antmerlino/Micromouse/Pictures/overalldesign_noIR.jpg

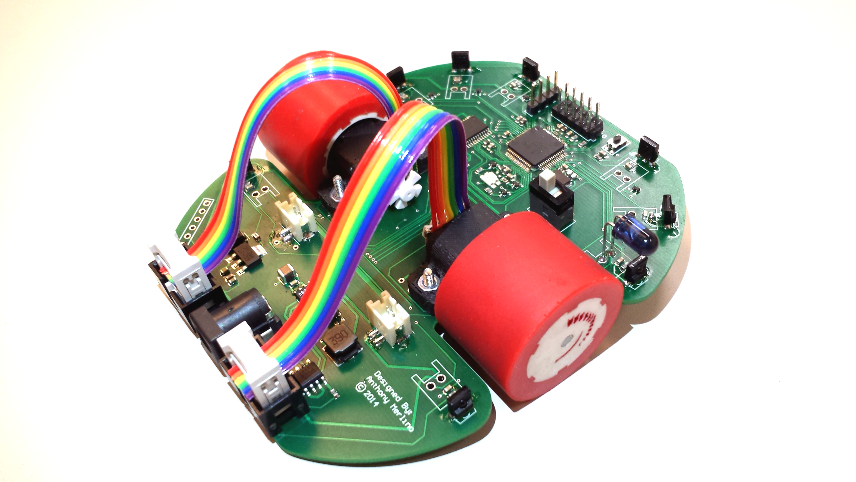
Pictures/overalldesign_noIR.jpg
