antmerlino/Micromouse/README.md

Micromouse
==========

Hardware and Software Design for IEEE Micromouse Competition
