antmerlino/Micromouse/Hardware/pin_information.xlsx

Sheet: Signals By Pin Number
Pin Number | Pin Name | Pin Type | Buffer Type | Description
1 | PB6 | I/O | TTL | GPIO port B bit 6.
 | M0PWM0 | O | TTL | Motion Control Module 0 PWM 0. This signal is controlled by Module 0 PWM Generator 0.
 | SSI2Rx | I | TTL | SSI module 2 receive.
 | T0CCP0 | I/O | TTL | 16/32-Bit Timer 0 Capture/Compare/PWM 0.
2 | VDDA | - | Power | The positive supply for the analog circuits (ADC, Analog Comparators, etc.). These are separated from VDD to minimize the electrical noise contained on VDD from affecting the analog functions. VDDA pins must be supplied with a voltage that meets the specification in Table 24-5 on page 1355, regardless of system implementation.
3 | GNDA | - | Power | The ground reference for the analog circuits (ADC, Analog Comparators, etc.). These are separated from GND to minimize the electrical noise contained on VDD from affecting the analog functions.
4 | PB7 | I/O | TTL | GPIO port B bit 7.
 | M0PWM1 | O | TTL | Motion Control Module 0 PWM 1. This signal is controlled by Module 0 PWM Generator 0.
 | SSI2Tx | O | TTL | SSI module 2 transmit.
 | T0CCP1 | I/O | TTL | 16/32-Bit Timer 0 Capture/Compare/PWM 1.
5 | PF4 | I/O | TTL | GPIO port F bit 4.
 | IDX0 | I | TTL | QEI module 0 index.
 | M1FAULT0 | I | TTL | Motion Control Module 1 PWM Fault 0.
 | T2CCP0 | I/O | TTL | 16/32-Bit Timer 2 Capture/Compare/PWM 0.
 | USB0EPEN | O | TTL | Optionally used in Host mode to control an external power source to supply power to the USB bus.
6 | PE3 | I/O | TTL | GPIO port E bit 3.
 | AIN0 | I | Analog | Analog-to-digital converter input 0.
7 | PE2 | I/O | TTL | GPIO port E bit 2.
 | AIN1 | I | Analog | Analog-to-digital converter input 1.
8 | PE1 | I/O | TTL | GPIO port E bit 1.
 | AIN2 | I | Analog | Analog-to-digital converter input 2.
 | U7Tx | O | TTL | UART module 7 transmit.
9 | PE0 | I/O | TTL | GPIO port E bit 0.
 | AIN3 | I | Analog | Analog-to-digital converter input 3.
 | U7Rx | I | TTL | UART module 7 receive.
10 | PD7 | I/O | TTL | GPIO port D bit 7.
 | NMI | I | TTL | Non-maskable interrupt.
 | PhB0 | I | TTL | QEI module 0 phase B.
 | U2Tx | O | TTL | UART module 2 transmit.
 | WT5CCP1 | I/O | TTL | 32/64-Bit Wide Timer 5 Capture/Compare/PWM 1.
11 | VDD | - | Power | Positive supply for I/O and some logic.
12 | GND | - | Power | Ground reference for logic and I/O pins.
13 | PC7 | I/O | TTL | GPIO port C bit 7.
 | C0- | I | Analog | Analog comparator 0 negative input.
 | U3Tx | O | TTL | UART module 3 transmit.
 | USB0PFLT | I | TTL | Optionally used in Host mode by an external power source to indicate an error state by that power source.
 | WT1CCP1 | I/O | TTL | 32/64-Bit Wide Timer 1 Capture/Compare/PWM 1.
14 | PC6 | I/O | TTL | GPIO port C bit 6.
 | C0+ | I | Analog | Analog comparator 0 positive input.
 | PhB1 | I | TTL | QEI module 1 phase B.
 | U3Rx | I | TTL | UART module 3 receive.
 | USB0EPEN | O | TTL | Optionally used in Host mode to control an external power source to supply power to the USB bus.
 | WT1CCP0 | I/O | TTL | 32/64-Bit Wide Timer 1 Capture/Compare/PWM 0.
15 | PC5 | I/O | TTL | GPIO port C bit 5.
 | C1+ | I | Analog | Analog comparator 1 positive input.
 | M0PWM7 | O | TTL | Motion Control Module 0 PWM 7. This signal is controlled by Module 0 PWM Generator 3.
 | PhA1 | I | TTL | QEI module 1 phase A.
 | U1CTS | I | TTL | UART module 1 Clear To Send modem flow control input signal.
 | U1Tx | O | TTL | UART module 1 transmit.
 | U4Tx | O | TTL | UART module 4 transmit.
 | WT0CCP1 | I/O | TTL | 32/64-Bit Wide Timer 0 Capture/Compare/PWM 1.
16 | PC4 | I/O | TTL | GPIO port C bit 4.
 | C1- | I | Analog | Analog comparator 1 negative input.
 | IDX1 | I | TTL | QEI module 1 index.
 | M0PWM6 | O | TTL | Motion Control Module 0 PWM 6. This signal is controlled by Module 0 PWM Generator 3.
 | U1RTS | O | TTL | UART module 1 Request to Send modem flow control output line.
 | U1Rx | I | TTL | UART module 1 receive.
 | U4Rx | I | TTL | UART module 4 receive.
 | WT0CCP0 | I/O | TTL | 32/64-Bit Wide Timer 0 Capture/Compare/PWM 0.
17 | PA0 | I/O | TTL | GPIO port A bit 0.
 | CAN1Rx | I | TTL | CAN module 1 receive.
 | U0Rx | I | TTL | UART module 0 receive.
18 | PA1 | I/O | TTL | GPIO port A bit 1.
 | CAN1Tx | O | TTL | CAN module 1 transmit.
 | U0Tx | O | TTL | UART module 0 transmit.
19 | PA2 | I/O | TTL | GPIO port A bit 2.
 | SSI0Clk | I/O | TTL | SSI module 0 clock
20 | PA3 | I/O | TTL | GPIO port A bit 3.
 | SSI0Fss | I/O | TTL | SSI module 0 frame signal
21 | PA4 | I/O | TTL | GPIO port A bit 4.
 | PA5 | O | TTL | SSI module 0 receive
22 | SSI0Tx | O | TTL | SSI module 0 transmit
 | PA6 | I/O | TTL | GPIO port A bit 6.
23 | I2C1SCL | I/O | OD | I2C module 1 clock. Note that this signal has an active pull-up. The corresponding port pin should not be configured as open drain.
 | M1PWM2 | O | TTL | Motion Control Module 1 PWM 2. This signal is controlled by Module 1 PWM Generator 1.
24 | PA7 | I/O | TTL | GPIO port A bit 7.
 | I2C1SDA | I/O | OD | I2C module 1 data.
 | M1PWM3 | O | TTL | Motion Control Module 1 PWM 3. This signal is controlled by Module 1 PWM Generator 1.
25 | VDDC | - | Power | Positive supply for most of the logic function, including the processor core and most peripherals. The voltage on this pin is 1.2 V and is supplied by the on-chip LDO. The VDDC pins should only be connected to each other and an external capacitor specified in Table 24-12 on page 1367 .
26 | VDD | - | Power | Positive supply for I/O and some logic.
27 | GND | - | Power | Ground reference for logic and I/O pins.
28 | PF0 | I/O | TTL | GPIO port F bit 0.
 | C0o | O | TTL | Analog comparator 0 output.
 | CAN0Rx | I | TTL | CAN module 0 receive.
 | M1PWM4 | O | TTL | Motion Control Module 1 PWM 4. This signal is controlled by Module 1 PWM Generator 2.
 | NMI | I | TTL | Non-maskable interrupt.
 | PhA0 | I | TTL | QEI module 0 phase A.
 | SSI1Rx | I | TTL | SSI module 1 receive.
 | T0CCP0 | I/O | TTL | 16/32-Bit Timer 0 Capture/Compare/PWM 0.
 | U1RTS | O | TTL | UART module 1 Request to Send modem flow control output line.
29 | PF1 | I/O | TTL | GPIO port F bit 1.
 | C1o | O | TTL | Analog comparator 1 output.
 | M1PWM5 | O | TTL | Motion Control Module 1 PWM 5. This signal is controlled by Module 1 PWM Generator 2.
 | PhB0 | I | TTL | QEI module 0 phase B.
 | SSI1Tx | O | TTL | SSI module 1 transmit.
 | T0CCP1 | I/O | TTL | 16/32-Bit Timer 0 Capture/Compare/PWM 1.
 | TRD1 | O | TTL | Trace data 1.
 | U1CTS | I | TTL | UART module 1 Clear To Send modem flow control input signal.
30 | PF2 | I/O | TTL | GPIO port F bit 2.
 | M0FAULT0 | I | TTL | Motion Control Module 0 PWM Fault 0.
 | M1PWM6 | O | TTL | Motion Control Module 1 PWM 6. This signal is controlled by Module 1 PWM Generator 3.
 | SSI1Clk | I/O | TTL | SSI module 1 clock.
 | T1CCP0 | I/O | TTL | 16/32-Bit Timer 1 Capture/Compare/PWM 0.
 | TRD0 | O | TTL | Trace data 0.
31 | PF3 | I/O | TTL | GPIO port F bit 3.
 | CAN0Tx | O | TTL | CAN module 0 transmit.
 | M1PWM7 | O | TTL | Motion Control Module 1 PWM 7. This signal is controlled by Module 1 PWM Generator 3.
 | SSI1Fss | I/O | TTL | SSI module 1 frame signal.
 | T1CCP1 | I/O | TTL | 16/32-Bit Timer 1 Capture/Compare/PWM 1.
 | TRCLK | O | TTL | Trace clock.
32 | WAKE | I | TTL | An external input that brings the processor out of Hibernate mode when asserted.
33 | HIB | O | TTL | An output that indicates the processor is in Hibernate mode.
34 | XOSC0 | I | Analog | Hibernation module oscillator crystal input or an external clock reference input. Note that this is either a 32.768-kHz crystal or a 32.768-kHz oscillator for the Hibernation module RTC.
35 | GNDX | - | Power | GND for the Hibernation oscillator. When using a crystal clock source, this pin should be connected to digital ground along with the crystal load capacitors. When using an external oscillator, this pin should be connected to digital ground
36 | XOSC1 | O | Analog | Hibernation module oscillator crystal output. Leave unconnected when using a single-ended clock source.
37 | VBAT | - | Power | Power source for the Hibernation module. It is normally connected to the positive terminal of a battery and serves as the battery backup/Hibernation module power-source supply. to the positive terminal of a battery and serves as the battery backup/Hibernation module power-source supply
38 | RST | I | TTL | System reset input.
39 | GND | - | Power | Ground reference for logic and I/O pins.
40 | OSC0 | I | Analog | Main oscillator crystal input or an external clock reference input.
41 | OSC1 | O | Analog | Main oscillator crystal output. Leave unconnected when using a single-ended clock source.
42 | VDD | - | Power | Positive supply for I/O and some logic.
43 | PD4 | I/O | TTL | GPIO port D bit 4. This pin is not 5-V tolerant.
 | U6Rx | I | TTL | UART module 6 receive.
 | USB0DM | I/O | Analog | Bidirectional differential data pin (D- per USB specification) for USB0.
44 | WT4CCP0 | I/O | TTL | 32/64-Bit Wide Timer 4 Capture/Compare/PWM 0.
 | PD5 | I/O | TTL | GPIO port D bit 5. This pin is not 5-V tolerant.
 | U6Tx | O | TTL | UART module 6 transmit.
 | USB0DP | I/O | Analog | Bidirectional differential data pin (D+ per USB specification) for USB0.
 | WT4CCP1 | I/O | TTL | 32/64-Bit Wide Timer 4 Capture/Compare/PWM 1.
45 | PB0 | I/O | TTL | GPIO port B bit 0. This pin is not 5-V tolerant
 | T2CCP0 | I/O | TTL | 16/32-Bit Timer 2 Capture/Compare/PWM 0
 | U1RX | I | TTL | UART module 1 receive
 | USB0ID | I | Analog | This signal senses the state of the USB ID signal. The USB PHY enables an integrated pull-up, and an external element (USB connector) indicates the initial state of the USB controller (pulled down is the A side of the cable and pulled up is the B side)
46 | PB1 | I/O | TTL | GPIO port B bit 1. This pin is not 5-V tolerant
 | T2CCP1 | I/O | TTL | 16/32-Bit Timer 2 Capture/Compare/PWM 1
 | U1Tx | O | TTL | UART module 1 transmit.
 | USB0VBUS | I/O | Analog | This signal is used during the session request protocol. This signal allows the USB PHY to both sense the voltage level of VBUS, and pull up VBUS momentarily during VBUS pulsing
47 | PB2 | I/O | TTL | GPIO port A bit 2.
 | I2C0SCL | I/O | OD | I2C module 0 clock. Note that this signal has an active pull-up. The corresponding port pin should not be configured as open drain.
 | T3CCP1 | I/O | TTL | 16/32-Bit Timer 3 Capture/Compare/PWM 1
48 | PB3 | I/O | TTL | GPIO port B bit 3.
 | I2C0SDA | I/O | OD | I2C module 0 data.
 | T3CCP1 | I/O | TTL | 16/32-Bit Timer 3 Capture/Compare/PWM 1.
49 | PC3 | I/O | TTL | GPIO port C bit 3.
 | SWO | O | TTL | JTAG TDO and SWO.
 | T5CCP1 | I/O | TTL | 16/32-Bit Timer 5 Capture/Compare/PWM 1.
 | TDO | O | TTL | JTAG TDO and SWO.
50 | PC2 | I/O | TTL | GPIO port C bit 2.
 | T5CCP0 | I/O | TTL | 16/32-Bit Timer 5 Capture/Compare/PWM 0.
 | TDI | I | TTL | JTAG TDI.
51 | PC1 | I/O | TTL | GPIO port C bit 1.
 | SWDIO | I/O | TTL | JTAG TMS and SWDIO.
 | T4CCP1 | I/O | TTL | 16/32-Bit Timer 4 Capture/Compare/PWM 1.
 | TMS | I | TTL | JTAG TMS and SWDIO.
52 | PC0 | I/O | TTL | GPIO port C bit 0.
 | SWCLK | I | TTL | JTAG/SWD CLK.
 | T4CCP0 | I/O | TTL | 16/32-Bit Timer 4 Capture/Compare/PWM 0.
 | TCK | I | TTL | JTAG/SWD CLK.
53 | PD6 | I/O | TTL | GPIO port D bit 6.
 | M0FAULT0 | I | TTL | Motion Control Module 0 PWM Fault 0.
 | PhA0 | I | TTL | QEI module 0 phase A.
 | U2Rx | I | TTL | UART module 2 receive.
 | WT5CCP0 | I/O | TTL | 32/64-Bit Wide Timer 5 Capture/Compare/PWM 0.
54 | VDD | - | Power | Positive supply for I/O and some logic.
55 | GND | - | Power | Ground reference for logic and I/O pins.
56 | VDDC | - | Power | Positive supply for most of the logic function, including the processor core and most peripherals. The voltage on this pin is 1.2 V and is supplied by the on-chip LDO. The VDDC pins should only be connected to each other and an external capacitor as specified in Table 24-12 on page 1367 .
57 | PB5 | I/O | TTL | GPIO port B bit 5.
 | AIN11 | I | Analog | Analog-to-digital converter input 11.
 | CAN0Tx | O | TTL | CAN module 0 transmit.
 | M0PWM3 | O | TTL | Motion Control Module 0 PWM 3. This signal is controlled by Module 0 PWM Generator 1.
 | SSI2Fss | I/O | TTL | SSI module 2 frame signal.
 | T1CCP1 | I/O | TTL | 16/32-Bit Timer 1 Capture/Compare/PWM 1.
58 | PB4 | I/O | TTL | GPIO port B bit 4.
 | AIN10 | I | Analog | Analog-to-digital converter input 10.
 | CAN0Rx | I | TTL | CAN module 0 receive.
 | M0PWM2 | O | TTL | Motion Control Module 0 PWM 2. This signal is controlled by Module 0 PWM Generator 1.
 | SSI2Clk | I/O | TTL | SSI module 2 clock.
 | T1CCP0 | I/O | TTL | 16/32-Bit Timer 1 Capture/Compare/PWM 0.
59 | PE4 | I/O | TTL | GPIO port E bit 4.
 | AIN9 | I | Analog | Analog-to-digital converter input 9.
 | CAN0Rx | I | TTL | CAN module 0 receive.
 | I2C2SCL | I/O | OD | I2C module 2 clock. Note that this signal has an active pull-up. The corresponding port pin should not be configured as open drain.
 | M0PWM4 | O | TTL | Motion Control Module 0 PWM 4. This signal is controlled by Module 0 PWM Generator 2.
 | M1PWM2 | O | TTL | Motion Control Module 1 PWM 2. This signal is controlled by Module 1 PWM Generator 1.
 | U5Rx | I | TTL | UART module 5 receive.
60 | PE5 | I/O | TTL | GPIO port E bit 5.
 | AIN8 | I | Analog | Analog-to-digital converter input 8.
 | CAN0Tx | O | TTL | CAN module 0 transmit.
 | I2C2SDA | I/O | OD | I2C module 2 data.
 | M0PWM5 | O | TTL | Motion Control Module 0 PWM 5. This signal is controlled by Module 0 PWM Generator 2.
 | M1PWM3 | O | TTL | Motion Control Module 1 PWM 3. This signal is controlled by Module 1 PWM Generator 1.
 | U5Tx | O | TTL | UART module 5 transmit.
61 | PD0 | I/O | TTL | GPIO port D bit 0.
 | AIN7 | I | Analog | Analog-to-digital converter input 7.
 | I2C3SCL | I/O | OD | I2C module 3 clock. Note that this signal has an active pull-up. The corresponding port pin should not be configured as open drain.
 | M0PWM6 | O | TTL | Motion Control Module 0 PWM 6. This signal is controlled by Module 0 PWM Generator 3.
 | M1PWM0 | O | TTL | Motion Control Module 1 PWM 0. This signal is controlled by Module 1 PWM Generator 0.
 | SSI1Clk | I/O | TTL | SSI module 1 clock.
 | SSI3Clk | I/O | TTL | SSI module 3 clock.
 | WT2CCP0 | I/O | TTL | 32/64-Bit Wide Timer 2 Capture/Compare/PWM 0.
62 | PD1 | I/O | TTL | GPIO port D bit 1.
 | AIN6 | I | Analog | Analog-to-digital converter input 6.
 | I2C3SDA | I/O | OD | I2C module 3 data.
 | M0PWM7 | O | TTL | Motion Control Module 0 PWM 7. This signal is controlled by
 | M1PWM1 | O | TTL | Motion Control Module 1 PWM 1. This signal is controlled by Module 1 PWM Generator 0.
 | SSI1Fss | I/O | TTL | SSI module 1 frame signal.
 | SSI3Fss | I/O | TTL | SSI module 3 frame signal.
 | WT2CCP1 | I/O | TTL | 32/64-Bit Wide Timer 2 Capture/Compare/PWM 1.
63 | PD2 | I/O | TTL | GPIO port D bit 2.
 | AIN5 | I | Analog | Analog-to-digital converter input 5.
 | M0FAULT0 | I | TTL | Motion Control Module 0 PWM Fault 0.
 | SSI1Rx | I | TTL | SSI module 1 receive.
 | SSI3Rx | I | TTL | SSI module 3 receive.
 | USB0EPEN | O | TTL | Optionally used in Host mode to control an external power source to supply power to the USB bus.
 | WT3CCP0 | I/O | TTL | 32/64-Bit Wide Timer 3 Capture/Compare/PWM 0.
64 | PD3 | I/O | TTL | GPIO port D bit 3.
 | AIN4 | I | Analog | Analog-to-digital converter input 4.
 | IDX0 | I | TTL | QEI module 0 index.
 | SSI1Tx | O | TTL | SSI module 1 transmit.
 | SSI3Tx | O | TTL | SSI module 3 transmit.
 | USB0PFLT | I | TTL | Optionally used in Host mode by an external power source to indicate an error state by that power source.
 | WT3CCP1 | I/O | TTL | 32/64-Bit Wide Timer 3 Capture/Compare/PWM 1.

Sheet: Signals By Pin Name
Pin Name | Pin Number | Pin Mux / Pin Assignment | Pin Type | Buffer Typea | Description
AIN0 | 6 | PE3 | I | Analog | Analog-to-digital converter input 0.
AIN1 | 7 | PE2 | I | Analog | Analog-to-digital converter input 1.
AIN2 | 8 | PE1 | I | Analog | Analog-to-digital converter input 2.
AIN3 | 9 | PE0 | I | Analog | Analog-to-digital converter input 3.
AIN4 | 64 | PD3 | I | Analog | Analog-to-digital converter input 4.
AIN5 | 63 | PD2 | I | Analog | Analog-to-digital converter input 5.
AIN6 | 62 | PD1 | I | Analog | Analog-to-digital converter input 6.
AIN7 | 61 | PD0 | I | Analog | Analog-to-digital converter input 7.
AIN8 | 60 | PE5 | I | Analog | Analog-to-digital converter input 8.
AIN9 | 59 | PE4 | I | Analog | Analog-to-digital converter input 9.
AIN10 | 58 | PB4 | I | Analog | Analog-to-digital converter input 10.
AIN11 | 57 | PB5 | I | Analog | Analog-to-digital converter input 11.
C0+ | 14 | PC6 | I | Analog | Analog comparator 0 positive input.
C0- | 13 | PC7 | I | Analog | Analog comparator 0 negative input.
C0o | 28 | PF0 (9) | O | TTL | Analog comparator 0 output.
C1+ | 15 | PC5 | I | Analog | Analog comparator 1 positive input.
C1- | 16 | PC4 | I | Analog | Analog comparator 1 negative input.
C1o | 29 | PF1 (9) | O | TTL | Analog comparator 1 output.
CAN0Rx | 28 | PF0 (3) | I | TTL | CAN module 0 receive.
 | 58 | PB4 (8)
 | 59 | PE4 (8)
CAN0Tx | 31 | PF3 (3) | O | TTL | CAN module 0 transmit.
 | 57 | PB5 (8)
 | 60 | PE5 (8)
CAN1Rx | 17 | PA0 (8) | I | TTL | CAN module 1 receive.
CAN1Tx | 18 | PA1 (8) | O | TTL | CAN module 1 transmit.
GND | 12 | fixed | - | Power | Ground reference for logic and I/O pins.
 | 27
 | 39
 | 55
GNDA | 3 | fixed | - | Power | The ground reference for the analog circuits (ADC, Analog Comparators, etc.). These are separated from GND to minimize the electrical noise contained on VDD from affecting the analog functions.
GNDX | 35 | fixed | - | Power | GND for the Hibernation oscillator. When using a crystal clock source, this pin should be connected capacitors. When using an external oscillator, this pin should be connected to digital ground.
HIB | 33 | fixed | O | TTL | An output that indicates the processor is in active pull-up. The corresponding port pin should Hibernate mode.
I2C0SCL | 47 | PB2 (3) | I/O | OD | I2C module 0 clock. Note that this signal has an not be configured as open drain.
I2C0SDA | 48 | PB3 (3) | I/O | OD | I2C module 0 data.
I2C1SCL | 23 | PA6 (3) | I/O | OD | I2C module 1 clock. Note that this signal has an active pull-up. The corresponding port pin should not be configured as open drain.
I2C1SDA | 24 | PA7 (3) | I/O | OD | I2C module 1 data.
I2C2SCL | 59 | PE4 (3) | I/O | OD | I2C module 2 clock. Note that this signal has an active pull-up. The corresponding port pin should not be configured as open drain.
I2C2SDA | 60 | PE5 (3) | I/O | OD | I2C module 2 data.
I2C3SCL | 61 | PD0 (3) | I/O | OD | I2C module 3 clock. Note that this signal has an active pull-up. The corresponding port pin should not be configured as open drain.
I2C3SDA | 62 | PD1 (3) | I/O | OD | I2C module 3 data.
IDX0 | 5 | PF4 (6) | I | TTL | QEI module 0 index.
 | 64 | PD3 (6)
IDX1 | 16 | PC4 (6) | I | TTL | QEI module 1 index.
M0FAULT0 | 30 | PF2 (4) | I | TTL | Motion Control Module 0 PWM Fault 0.
 | 53 | PD6 (4)
 | 63 | PD2 (4)
M0PWM0 | 1 | PB6 (4) | O | TTL | Motion Control Module 0 PWM 0. This signal is controlled by Module 0 PWM Generator 0.
M0PWM1 | 4 | PB7 (4) | O | TTL | Motion Control Module 0 PWM 1. This signal is controlled by Module 0 PWM Generator 0.
M0PWM2 | 58 | PB4 (4) | O | TTL | Motion Control Module 0 PWM 2. This signal is controlled by Module 0 PWM Generator 1.
M0PWM3 | 57 | PB5 (4) | O | TTL | Motion Control Module 0 PWM 3. This signal is controlled by Module 0 PWM Generator 1.
M0PWM4 | 59 | PE4 (4) | O | TTL | Motion Control Module 0 PWM 4. This signal is controlled by Module 0 PWM Generator 2.
M0PWM5 | 60 | PE5 (4) | O | TTL | Motion Control Module 0 PWM 5. This signal is controlled by Module 0 PWM Generator 2.
M0PWM6 | 16 | PC4 (4) | O | TTL | Motion Control Module 0 PWM 6. This signal is controlled by Module 0 PWM Generator 3.
 | 61 | PD0 (4)
M0PWM7 | 15 | PC5 (4) | O | TTL | Motion Control Module 0 PWM 7. This signal is controlled by Module 0 PWM Generator 3.
 | 62 | PD1 (4)
M1FAULT0 | 5 | PF4 (5) | I | TTL | Motion Control Module 1 PWM Fault 0.
M1PWM0 | 61 | PD0 (5) | O | TTL | Motion Control Module 1 PWM 0. This signal is controlled by Module 1 PWM Generator 0.
M1PWM1 | 62 | PD1 (5) | O | TTL | Motion Control Module 1 PWM 1. This signal is controlled by Module 1 PWM Generator 0.
M1PWM2 | 23 | PA6 (5) | O | TTL | Motion Control Module 1 PWM 2. This signal is controlled by Module 1 PWM Generator 1.
 | 59 | PE4 (5)
M1PWM3 | 24 | PA7 (5) | O | TTL | Motion Control Module 1 PWM 3. This signal is controlled by Module 1 PWM Generator 1.
 | 60 | PE5 (5)
M1PWM4 | 28 | PF0 (5) | O | TTL | Motion Control Module 1 PWM 4. This signal is controlled by Module 1 PWM Generator 2.
M1PWM5 | 29 | PF1 (5) | O | TTL | Motion Control Module 1 PWM 5. This signal is controlled by Module 1 PWM Generator 2.
M1PWM6 | 30 | PF2 (5) | O | TTL | Motion Control Module 1 PWM 6. This signal is controlled by Module 1 PWM Generator 3.
M1PWM7 | 31 | PF3 (5) | O | TTL | Motion Control Module 1 PWM 7. This signal is controlled by Module 1 PWM Generator 3.
NMI | 10 | PD7 (8) | I | TTL | Non-maskable interrupt.
 | 28 | PF0 (8)
OSC0 | 40 | fixed | I | Analog | Main oscillator crystal input or an external clock reference input.
OSC1 | 41 | fixed | O | Analog | Main oscillator crystal output. Leave unconnected when using a single-ended clock source.
PA0 | 17 | - | I/O | TTL | GPIO port A bit 0.
PA1 | 18 | - | I/O | TTL | GPIO port A bit 1.
PA2 | 19 | - | I/O | TTL | GPIO port A bit 2.
PA3 | 20 | - | I/O | TTL | GPIO port A bit 3.
PA4 | 21 | - | I/O | TTL | GPIO port A bit 4.
PA5 | 22 | - | I/O | TTL | GPIO port A bit 5.
PA6 | 23 | - | I/O | TTL | GPIO port A bit 6.
PA7 | 24 | - | I/O | TTL | GPIO port A bit 7.
PB0 | 45 | - | I/O | TTL | GPIO port B bit 0. This pin is not 5-V tolerant.
PB1 | 46 | - | I/O | TTL | GPIO port B bit 1. This pin is not 5-V tolerant.
PB2 | 47 | - | I/O | TTL | GPIO port B bit 2.
PB3 | 48 | - | I/O | TTL | GPIO port B bit 3.
PB4 | 58 | - | I/O | TTL | GPIO port B bit 4.
PB5 | 57 | - | I/O | TTL | GPIO port B bit 5.
PB6 | 1 | - | I/O | TTL | GPIO port B bit 6.
PB7 | 4 | - | I/O | TTL | GPIO port B bit 7.
PC0 | 52 | - | I/O | TTL | GPIO port C bit 0.
PC1 | 51 | - | I/O | TTL | GPIO port C bit 1.
PC2 | 50 | - | I/O | TTL | GPIO port C bit 2.
PC3 | 49 | - | I/O | TTL | GPIO port C bit 3.
PC4 | 16 | - | I/O | TTL | GPIO port C bit 4.
PC5 | 15 | - | I/O | TTL | GPIO port C bit 5.
PC6 | 14 | - | I/O | TTL | GPIO port C bit 6.
PC7 | 13 | - | I/O | TTL | GPIO port C bit 7.
PD0 | 61 | - | I/O | TTL | GPIO port D bit 0.
PD1 | 62 | - | I/O | TTL | GPIO port D bit 1.
PD2 | 63 | - | I/O | TTL | GPIO port D bit 2.
PD3 | 64 | - | I/O | TTL | GPIO port D bit 3.
PD4 | 43 | - | I/O | TTL | GPIO port D bit 4. This pin is not 5-V tolerant.
PD5 | 44 | - | I/O | TTL | GPIO port D bit 5. This pin is not 5-V tolerant.
PD6 | 53 | - | I/O | TTL | GPIO port D bit 6.
PD7 | 10 | - | I/O | TTL | GPIO port D bit 7.
PE0 | 9 | - | I/O | TTL | GPIO port E bit 0.
PE1 | 8 | - | I/O | TTL | GPIO port E bit 1.
PE2 | 7 | - | I/O | TTL | GPIO port E bit 2.
PE3 | 6 | - | I/O | TTL | GPIO port E bit 3.
PE4 | 59 | - | I/O | TTL | GPIO port E bit 4.
PE5 | 60 | - | I/O | TTL | GPIO port E bit 5.
PF0 | 28 | - | I/O | TTL | GPIO port F bit 0.
PF1 | 29 | - | I/O | TTL | GPIO port F bit 1.
PF2 | 30 | - | I/O | TTL | GPIO port F bit 2.
PF3 | 31 | - | I/O | TTL | GPIO port F bit 3.
PF4 | 5 | - | I/O | TTL | GPIO port F bit 4.
PhA0 | 28 | PF0 (6) | I | TTL | QEI module 0 phase A.
 | 53 | PD6 (6)
PhA1 | 15 | PC5 (6) | I | TTL | QEI module 1 phase A.
PhB0 | 10 | PD7 (6) | I | TTL | QEI module 0 phase B.
 | 29 | PF1 (6)
PhB1 | 14 | PC6 (6) | I | TTL | QEI module 1 phase B.
RST | 38 | fixed | I | TTL | System reset input.
SSI0Clk | 19 | PA2 (2) | I/O | TTL | SSI module 0 clock
SSI0Fss | 20 | PA3 (2) | I/O | TTL | SSI module 0 frame signal
SSI0Rx | 21 | PA4 (2) | I | TTL | SSI module 0 receive
SSI0Tx | 22 | PA5 (2) | O | TTL | SSI module 0 transmit
SSI1Clk | 30 | PF2 (2) | I/O | TTL | SSI module 1 clock.
 | 61 | PD0 (2)
SSI1Fss | 31 | PF3 (2) | I/O | TTL | SSI module 1 frame signal.
 | 62 | PD1 (2)
SSI1Rx | 28 | PF0 (2) | I | TTL | SSI module 1 receive.
 | 63 | PD2 (2)
SSI1Tx | 29 | PF1 (2) | O | TTL | SSI module 1 transmit.
 | 64 | PD3 (2)
SSI2Clk | 58 | PB4 (2) | I/O | TTL | SSI module 2 clock.
SSI2Fss | 57 | PB5 (2) | I/O | TTL | SSI module 2 frame signal.
SSI2Rx | 1 | PB6 (2) | I | TTL | SSI module 2 receive.
SSI2Tx | 4 | PB7 (2) | O | TTL | SSI module 2 transmit.
SSI3Clk | 61 | PD0 (1) | I/O | TTL | SSI module 3 clock.
SSI3Fss | 62 | PD1 (1) | I/O | TTL | SSI module 3 frame signal.
SSI3Rx | 63 | PD2 (1) | I | TTL | SSI module 3 receive.
SSI3Tx | 64 | PD3 (1) | O | TTL | SSI module 3 transmit.
SWCLK | 52 | PC0 (1) | I | TTL | JTAG/SWD CLK.
SWDIO | 51 | PC1 (1) | I/O | TTL | JTAG TMS and SWDIO.
SWO | 49 | PC3 (1) | O | TTL | JTAG TDO and SWO.
T0CCP0 | 1 | PB6 (7) | I/O | TTL | 16/32-Bit Timer 0 Capture/Compare/PWM 0.
 | 28 | PF0 (7)
T0CCP1 | 4 | PB7 (7) | I/O | TTL | 16/32-Bit Timer 0 Capture/Compare/PWM 1.
 | 29 | PF1 (7)
T1CCP0 | 30 | PF2 (7) | I/O | TTL | 16/32-Bit Timer 1 Capture/Compare/PWM 0.
 | 58 | PB4 (7)
T1CCP1 | 31 | PF3 (7) | I/O | TTL | 16/32-Bit Timer 1 Capture/Compare/PWM 1.
 | 57 | PB5 (7)
T2CCP0 | 5 | PF4 (7) | I/O | TTL | 16/32-Bit Timer 2 Capture/Compare/PWM 0.
 | 45 | PB0 (7)
T2CCP1 | 46 | PB1 (7) | I/O | TTL | 16/32-Bit Timer 2 Capture/Compare/PWM 1.
T3CCP0 | 47 | PB2 (7) | I/O | TTL | 16/32-Bit Timer 3 Capture/Compare/PWM 0.
T3CCP1 | 48 | PB3 (7) | I/O | TTL | 16/32-Bit Timer 3 Capture/Compare/PWM 1.
T4CCP0 | 52 | PC0 (7) | I/O | TTL | 16/32-Bit Timer 4 Capture/Compare/PWM 0.
T4CCP1 | 51 | PC1 (7) | I/O | TTL | 16/32-Bit Timer 4 Capture/Compare/PWM 1.
T5CCP0 | 50 | PC2 (7) | I/O | TTL | 16/32-Bit Timer 5 Capture/Compare/PWM 0.
T5CCP1 | 49 | PC3 (7) | I/O | TTL | 16/32-Bit Timer 5 Capture/Compare/PWM 1.
TCK | 52 | PC0 (1) | I | TTL | JTAG/SWD CLK.
TDI | 50 | PC2 (1) | I | TTL | JTAG TDI.
TDO | 49 | PC3 (1) | O | TTL | JTAG TDO and SWO.
TMS | 51 | PC1 (1) | I | TTL | JTAG TMS and SWDIO.
TRCLK | 31 | PF3 (14) | O | TTL | Trace clock.
TRD0 | 30 | PF2 (14) | O | TTL | Trace data 0.
TRD1 | 29 | PF1 (14) | O | TTL | Trace data 1.
U0Rx | 17 | PA0 (1) | I | TTL | UART module 0 receive.
U0Tx | 18 | PA1 (1) | O | TTL | UART module 0 transmit.
U1CTS | 15 | PC5 (8) | I | TTL | UART module 1 Clear To Send modem flow control input signal.
 | 29 | PF1 (1)
U1RTS | 16 | PC4 (8) | O | TTL | UART module 1 Request to Send modem flow control output line.
 | 28 | PF0 (1)
U1Rx | 16 | PC4 (2) | I | TTL | UART module 1 receive.
 | 45 | PB0 (1)
U1Tx | 15 | PC5 (2) | O | TTL | UART module 1 transmit.
 | 46 | PB1 (1)
U2Rx | 53 | PD6 (1) | I | TTL | UART module 2 receive.
U2Tx | 10 | PD7 (1) | O | TTL | UART module 2 transmit.
U3Rx | 14 | PC6 (1) | I | TTL | UART module 3 receive.
U3Tx | 13 | PC7 (1) | O | TTL | UART module 3 transmit.
U4Rx | 16 | PC4 (1) | I | TTL | UART module 4 receive.
U4Tx | 15 | PC5 (1) | O | TTL | UART module 4 transmit.
U5Rx | 59 | PE4 (1) | I | TTL | UART module 5 receive.
U5Tx | 60 | PE5 (1) | O | TTL | UART module 5 transmit.
U6Rx | 43 | PD4 (1) | I | TTL | UART module 6 receive.
U6Tx | 44 | PD5 (1) | O | TTL | UART module 6 transmit.
U7Rx | 9 | PE0 (1) | I | TTL | UART module 7 receive.
U7Tx | 8 | PE1 (1) | O | TTL | UART module 7 transmit.
USB0DM | 43 | PD4 | I/O | Analog | Bidirectional differential data pin (D-per USB specification) for USB0.
USB0DP | 44 | PD5 | I/O | Analog | Bidirectional differential data pin (D+ per USB specification) for USB0.
USB0EPEN | 5 | PF4 (8) | O | TTL | Optionally used in Host mode to control an external power source to supply power to the USB bus.
 | 14 | PC6 (8)
 | 63 | PD2 (8)
USB0ID | 45 | PB0 | I | Analog | This signal senses the state of the USB ID signal. The USB PHY enables an integrated pull-up, and an external element (USB connector) indicates the initial state of the USB controller (pulled down is the A side of the cable and pulled up is the B side).
USB0PFLT | 13 | PC7 (8) | I | TTL | Optionally used in Host mode by an external power source to indicate an error state by that power source.
 | 64 | PD3 (8)
USB0VBUS | 46 | PB1 | I/O | Analog | This signal is used during the session request protocol. This signal allows the USB PHY to both sense the voltage level of VBUS, and pull up VBUS momentarily during VBUS pulsing.
VBAT | 37 | fixed | - | Power | Power source for the Hibernation module. It is normally connected to the positive terminal of a battery and serves as the battery backup/Hibernation module power-source supply.
VDD | 11 | fixed | - | Power | Positive supply for I/O and some logic.
 | 26
 | 42
 | 54
VDDA | 2 | fixed | - | Power | The positive supply for the analog circuits (ADC, Analog Comparators, etc.). These are separated from VDD to minimize the electrical noise contained on VDD from affecting the analog functions. VDDA pins must be supplied with a voltage that meets the specification in Table 24-5 on page 1355, regardless of system implementation.
VDDC | 25 | fixed | - | Power | Positive supply for most of the logic function, including the processor core and most peripherals. The voltage on this pin is 1.2 V and is supplied by the on-chip LDO. The VDDC pins should only be connected to each other and an external capacitor as specified in Table 24-12 on page 1367 .
 | 56
WAKE | 32 | fixed | I | TTL | An external input that brings the processor out of Hibernate mode when asserted.
WT0CCP0 | 16 | PC4 (7) | I/O | TTL | 32/64-Bit Wide Timer 0 Capture/Compare/PWM 0.
WT0CCP1 | 15 | PC5 (7) | I/O | TTL | 32/64-Bit Wide Timer 0 Capture/Compare/PWM 1.
WT1CCP0 | 14 | PC6 (7) | I/O | TTL | 32/64-Bit Wide Timer 1 Capture/Compare/PWM 0.
WT1CCP1 | 13 | PC7 (7) | I/O | TTL | 32/64-Bit Wide Timer 1 Capture/Compare/PWM 1.
WT2CCP0 | 61 | PD0 (7) | I/O | TTL | 32/64-Bit Wide Timer 2 Capture/Compare/PWM 0.
WT2CCP1 | 62 | PD1 (7) | I/O | TTL | 32/64-Bit Wide Timer 2 Capture/Compare/PWM 1.
WT3CCP0 | 63 | PD2 (7) | I/O | TTL | 32/64-Bit Wide Timer 3 Capture/Compare/PWM 0.
WT3CCP1 | 64 | PD3 (7) | I/O | TTL | 32/64-Bit Wide Timer 3 Capture/Compare/PWM 1.
WT4CCP0 | 43 | PD4 (7) | I/O | TTL | 32/64-Bit Wide Timer 4 Capture/Compare/PWM 0.
WT4CCP1 | 44 | PD5 (7) | I/O | TTL | 32/64-Bit Wide Timer 4 Capture/Compare/PWM 1.
WT5CCP0 | 53 | PD6 (7) | I/O | TTL | 32/64-Bit Wide Timer 5 Capture/Compare/PWM 0.
WT5CCP1 | 10 | PD7 (7) | I/O | TTL | 32/64-Bit Wide Timer 5 Capture/Compare/PWM 1.
XOSC0 | 34 | fixed | I | Analog | Hibernation module oscillator crystal input or an external clock reference input. Note that this is either a 32.768-kHz crystal or a 32.768-kHz oscillator for the Hibernation module RTC.
XOSC1 | 36 | fixed | O | Analog | Hibernation module oscillator crystal output. Leave unconnected when using a single-ended clock source.

Sheet: page 14
Function | Pin Name | Pin Number | Pin Type | Buffer Typea | Description
 | AIN0 | 6 | I | Analog | Analog-to-digital converter input 0.
 | AIN1 | 7 | I | Analog | Analog-to-digital converter input 1.
 | AIN2 | 8 | I | Analog | Analog-to-digital converter input 2.
 | AIN3 | 9 | I | Analog | Analog-to-digital converter input 3.
 | AIN4 | 64 | I | Analog | Analog-to-digital converter input 4.
AIN5 63 I Analog Analog-to-digital converter input 5.
ADC
 | AIN6 | 62 | I | Analog | Analog-to-digital converter input 6.
 | AIN7 | 61 | I | Analog | Analog-to-digital converter input 7.
 | AIN8 | 60 | I | Analog | Analog-to-digital converter input 8.
 | AIN9 | 59 | I | Analog | Analog-to-digital converter input 9.
 | AIN10 | 58 | I | Analog | Analog-to-digital converter input 10.
 | AIN11 | 57 | I | Analog | Analog-to-digital converter input 11.
 | C0+ | 14 | I | Analog | Analog comparator 0 positive input.
 | C0- | 13 | I | Analog | Analog comparator 0 negative input.
C0o 28 O TTL Analog comparator 0 output.
Analog Comparators
 | C1+ | 15 | I | Analog | Analog comparator 1 positive input.
 | C1- | 16 | I | Analog | Analog comparator 1 negative input.
 | C1o | 29 | O | TTL | Analog comparator 1 output.
 | CAN0Rx | 28 | I | TTL | CAN module 0 receive.
 |  | 58
 |  | 59
Controller Area | CAN0Tx | 31 | O | TTL | CAN module 0 transmit.
Network |  | 57
 |  | 60
 | CAN1Rx | 17 | I | TTL | CAN module 1 receive.
 | CAN1Tx | 18 | O | TTL | CAN module 1 transmit.

Sheet: page 15
 | Function | Pin Name | Pin Number | Pin Type | Buffer Typea | Description
 |  | TRCLK | 31 | O | TTL | Trace clock.
Core |  | TRD0 | 30 | O | TTL | Trace data 0.
 |  | TRD1 | 29 | O | TTL | Trace data 1.
 |  | T0CCP0 | 1 | I/O | TTL | 16/32-Bit Timer 0 Capture/Compare/PWM 0.
 |  |  | 28
 |  | T0CCP1 | 4 | I/O | TTL | 16/32-Bit Timer 0 Capture/Compare/PWM 1.
 |  |  | 29
 |  | T1CCP0 | 30 | I/O | TTL | 16/32-Bit Timer 1 Capture/Compare/PWM 0.
 |  |  | 58
 |  | T1CCP1 | 31 | I/O | TTL | 16/32-Bit Timer 1 Capture/Compare/PWM 1.
 |  |  | 57
 |  | T2CCP0 | 5 | I/O | TTL | 16/32-Bit Timer 2 Capture/Compare/PWM 0.
 |  |  | 45
 |  | T2CCP1 | 46 | I/O | TTL | 16/32-Bit Timer 2 Capture/Compare/PWM 1.
 |  | T3CCP0 | 47 | I/O | TTL | 16/32-Bit Timer 3 Capture/Compare/PWM 0.
 |  | T3CCP1 | 48 | I/O | TTL | 16/32-Bit Timer 3 Capture/Compare/PWM 1.
 |  | T4CCP0 | 52 | I/O | TTL | 16/32-Bit Timer 4 Capture/Compare/PWM 0.
T4CCP1 51 I/O TTL 16/32-Bit Timer 4 Capture/Compare/PWM 1.
General-Purpose
Timers |  | T5CCP0 | 50 | I/O | TTL | 16/32-Bit Timer 5 Capture/Compare/PWM 0.
 |  | T5CCP1 | 49 | I/O | TTL | 16/32-Bit Timer 5 Capture/Compare/PWM 1.
 |  | WT0CCP0 | 16 | I/O | TTL | 32/64-Bit Wide Timer 0 Capture/Compare/PWM 0.
 |  | WT0CCP1 | 15 | I/O | TTL | 32/64-Bit Wide Timer 0 Capture/Compare/PWM 1.
 |  | WT1CCP0 | 14 | I/O | TTL | 32/64-Bit Wide Timer 1 Capture/Compare/PWM 0.
 |  | WT1CCP1 | 13 | I/O | TTL | 32/64-Bit Wide Timer 1 Capture/Compare/PWM 1.
 |  | WT2CCP0 | 61 | I/O | TTL | 32/64-Bit Wide Timer 2 Capture/Compare/PWM 0.
 |  | WT2CCP1 | 62 | I/O | TTL | 32/64-Bit Wide Timer 2 Capture/Compare/PWM 1.
 |  | WT3CCP0 | 63 | I/O | TTL | 32/64-Bit Wide Timer 3 Capture/Compare/PWM 0.
 |  | WT3CCP1 | 64 | I/O | TTL | 32/64-Bit Wide Timer 3 Capture/Compare/PWM 1.
 |  | WT4CCP0 | 43 | I/O | TTL | 32/64-Bit Wide Timer 4 Capture/Compare/PWM 0.
 |  | WT4CCP1 | 44 | I/O | TTL | 32/64-Bit Wide Timer 4 Capture/Compare/PWM 1.
 |  | WT5CCP0 | 53 | I/O | TTL | 32/64-Bit Wide Timer 5 Capture/Compare/PWM 0.
 |  | WT5CCP1 | 10 | I/O | TTL | 32/64-Bit Wide Timer 5 Capture/Compare/PWM 1.

Sheet: page 16
Function | Pin Name | Pin Number | Pin Type | Buffer Typea | Description GND for the Hibernation oscillator. When using a crystal clock source, this pin should be connected to digital ground along with the crystal load capacitors. When using an external oscillator, this pin should be connected to digital ground. An output that indicates the processor is in Hibernate mode. Power source for the Hibernation module. It is normally connected to the positive terminal of a battery and serves as the battery backup/Hibernation module power-source supply.
 | GNDX | 35 | - | Power | Description GND for the Hibernation oscillator. When using a crystal clock source, this pin should be connected to digital ground along with the crystal load capacitors. When using an external oscillator, this pin should be connected to digital ground. An output that indicates the processor is in Hibernate mode. Power source for the Hibernation module. It is normally connected to the positive terminal of a battery and serves as the battery backup/Hibernation module power-source supply.
 | HIB | 33 | O | TTL | Description GND for the Hibernation oscillator. When using a crystal clock source, this pin should be connected to digital ground along with the crystal load capacitors. When using an external oscillator, this pin should be connected to digital ground. An output that indicates the processor is in Hibernate mode. Power source for the Hibernation module. It is normally connected to the positive terminal of a battery and serves as the battery backup/Hibernation module power-source supply.
 | VBAT | 37 | - | Power | Description GND for the Hibernation oscillator. When using a crystal clock source, this pin should be connected to digital ground along with the crystal load capacitors. When using an external oscillator, this pin should be connected to digital ground. An output that indicates the processor is in Hibernate mode. Power source for the Hibernation module. It is normally connected to the positive terminal of a battery and serves as the battery backup/Hibernation module power-source supply.
Hibernate |  |  |  |  | Description GND for the Hibernation oscillator. When using a crystal clock source, this pin should be connected to digital ground along with the crystal load capacitors. When using an external oscillator, this pin should be connected to digital ground. An output that indicates the processor is in Hibernate mode. Power source for the Hibernation module. It is normally connected to the positive terminal of a battery and serves as the battery backup/Hibernation module power-source supply.
 | WAKE | 32 | I | TTL | An external input that brings the processor out of Hibernate mode when asserted.
 | XOSC0 | 34 | I | Analog | Hibernation module oscillator crystal input or an external clock reference input. Note that this is
 |  |  |  |  | either a 32.768-kHz crystal or a 32.768-kHz
 |  |  |  |  | oscillator for the Hibernation module RTC.
 | XOSC1 | 36 | O | Analog | Hibernation module oscillator crystal output. Leave unconnected when using a single-ended clock
 |  |  |  |  | source.
 | I2C0SCL | 47 | I/O | OD | I2C module 0 clock. Note that this signal has an
 |  |  |  |  | active pull-up. The corresponding port pin should
 |  |  |  |  | not be configured as open drain.
 | I2C0SDA | 48 | I/O | OD | I2C module 0 data.
 | I2C1SCL | 23 | I/O | OD | I2C module 1 clock. Note that this signal has an
 |  |  |  |  | active pull-up. The corresponding port pin should
 |  |  |  |  | not be configured as open drain.
 | I2C1SDA | 24 | I/O | OD | I2C module 1 data.
 | I2C2SCL | 59 | I/O | OD | I2C module 2 clock. Note that this signal has an
 |  |  |  |  | active pull-up. The corresponding port pin should
 |  |  |  |  | not be configured as open drain.
 | I2C2SDA | 60 | I/O | OD | I2C module 2 data.
 | I2C3SCL | 61 | I/O | OD | I2C module 3 clock. Note that this signal has an
 |  |  |  |  | active pull-up. The corresponding port pin should
 |  |  |  |  | not be configured as open drain.
 | I2C3SDA | 62 | I/O | OD | I2C module 3 data.
 | SWCLK | 52 | I | TTL | JTAG/SWD CLK.
 | SWDIO | 51 | I/O | TTL | JTAG TMS and SWDIO.
 | SWO | 49 | O | TTL | JTAG TDO and SWO.
JTAG/SWD/SWO | TCK | 52 | I | TTL | JTAG/SWD CLK.
 | TDI | 50 | I | TTL | JTAG TDI.
 | TDO | 49 | O | TTL | JTAG TDO and SWO.
 | TMS | 51 | I | TTL | JTAG TMS and SWDIO.

Sheet: page 17
Function | Pin Name | Pin Number | Pin Type | Buffer Typea | Description
 | M0FAULT0 | 30 | I | TTL | Motion Control Module 0 PWM Fault 0.
 |  | 53
 |  | 63
 | M0PWM0 | 1 | O | TTL | Motion Control Module 0 PWM 0. This signal is controlled by Module 0 PWM Generator 0.
 | M0PWM1 | 4 | O | TTL | Motion Control Module 0 PWM 1. This signal is controlled by Module 0 PWM Generator 0.
 | M0PWM2 | 58 | O | TTL | Motion Control Module 0 PWM 2. This signal is controlled by Module 0 PWM Generator 1.
 | M0PWM3 | 57 | O | TTL | Motion Control Module 0 PWM 3. This signal is controlled by Module 0 PWM Generator 1.
 | M0PWM4 | 59 | O | TTL | Motion Control Module 0 PWM 4. This signal is controlled by Module 0 PWM Generator 2.
 | M0PWM5 | 60 | O | TTL | Motion Control Module 0 PWM 5. This signal is controlled by Module 0 PWM Generator 2.
 | M0PWM6 | 16 | O | TTL | Motion Control Module 0 PWM 6. This signal is
 |  | 61 |  |  | controlled by Module 0 PWM Generator 3.
 | M0PWM7 | 15 | O | TTL | Motion Control Module 0 PWM 7. This signal is
 |  | 62 |  |  | controlled by Module 0 PWM Generator 3.
 | M1FAULT0 | 5 | I | TTL | Motion Control Module 1 PWM Fault 0.
 | M1PWM0 | 61 | O | TTL | Motion Control Module 1 PWM 0. This signal is controlled by Module 1 PWM Generator 0.
 | M1PWM1 | 62 | O | TTL | Motion Control Module 1 PWM 1. This signal is controlled by Module 1 PWM Generator 0.
 | M1PWM2 | 23 | O | TTL | Motion Control Module 1 PWM 2. This signal is
 |  | 59 |  |  | controlled by Module 1 PWM Generator 1.
 | M1PWM3 | 24 | O | TTL | Motion Control Module 1 PWM 3. This signal is
 |  | 60 |  |  | controlled by Module 1 PWM Generator 1.
 | M1PWM4 | 28 | O | TTL | Motion Control Module 1 PWM 4. This signal is controlled by Module 1 PWM Generator 2.
 | M1PWM5 | 29 | O | TTL | Motion Control Module 1 PWM 5. This signal is controlled by Module 1 PWM Generator 2.
 | M1PWM6 | 30 | O | TTL | Motion Control Module 1 PWM 6. This signal is controlled by Module 1 PWM Generator 3.
 | M1PWM7 | 31 | O | TTL | Motion Control Module 1 PWM 7. This signal is controlled by Module 1 PWM Generator 3.

Sheet: page 18
Function | Pin Name | Pin Number | Pin Type | Buffer Typea | Description
 | GND | 12 | - | Power | Ground reference for logic and I/O pins.
 |  | 27
 |  | 39
 |  | 55
 | GNDA | 3 | - | Power | The ground reference for the analog circuits (ADC, Analog Comparators, etc.). These are separated
 |  |  |  |  | from GND to minimize the electrical noise contained
 |  |  |  |  | on VDD from affecting the analog functions.
 | VDD | 11 | - | Power | Positive supply for I/O and some logic.
 |  | 26
 |  | 42
 |  | 54
er | VDDA | 2 | - | Power | The positive supply for the analog circuits (ADC, Analog Comparators, etc.). These are separated
 |  |  |  |  | from VDD to minimize the electrical noise contained
 |  |  |  |  | on VDD from affecting the analog functions. VDDA pins must be supplied with a voltage that meets the
 |  |  |  |  | specification in Table 24-5 on page 1355, regardless
 |  |  |  |  | of system implementation.
 | VDDC | 25 | - | Power | Positive supply for most of the logic function,
 |  | 56 |  |  | including the processor core and most peripherals.
 |  |  |  |  | The voltage on this pin is 1.2 V and is supplied by
 |  |  |  |  | the on-chip LDO. The VDDC pins should only be connected to each other and an external capacitor
 |  |  |  |  | as specified in Table 24-12 on page 1367 .
 | IDX0 | 5 | I | TTL | QEI module 0 index.
 |  | 64
 | IDX1 | 16 | I | TTL | QEI module 1 index.
 | PhA0 | 28 | I | TTL | QEI module 0 phase A.
 |  | 53
 | PhA1 | 15 | I | TTL | QEI module 1 phase A.
 | PhB0 | 10 | I | TTL | QEI module 0 phase B.
 |  | 29
 | PhB1 | 14 | I | TTL | QEI module 1 phase B.

Sheet: page 19
 | SSI0Clk | 19 | I/O | TTL | SSI module 0 clock
 | SSI0Fss | 20 | I/O | TTL | SSI module 0 frame signal
 | SSI0Rx | 21 | I | TTL | SSI module 0 receive
 | SSI0Tx | 22 | O | TTL | SSI module 0 transmit
 | SSI1Clk | 30 | I/O | TTL | SSI module 1 clock.
 |  | 61
 | SSI1Fss | 31 | I/O | TTL | SSI module 1 frame signal.
 |  | 62
 | SSI1Rx | 28 | I | TTL | SSI module 1 receive.
 |  | 63
SSI | SSI1Tx | 29 | O | TTL | SSI module 1 transmit.
 |  | 64
 | SSI2Clk | 58 | I/O | TTL | SSI module 2 clock.
 | SSI2Fss | 57 | I/O | TTL | SSI module 2 frame signal.
 | SSI2Rx | 1 | I | TTL | SSI module 2 receive.
 | SSI2Tx | 4 | O | TTL | SSI module 2 transmit.
 | SSI3Clk | 61 | I/O | TTL | SSI module 3 clock.
 | SSI3Fss | 62 | I/O | TTL | SSI module 3 frame signal.
 | SSI3Rx | 63 | I | TTL | SSI module 3 receive.
 | SSI3Tx | 64 | O | TTL | SSI module 3 transmit.
 | NMI | 10 | I | TTL | Non-maskable interrupt.
 |  | 28
 | OSC0 | 40 | I | Analog | Main oscillator crystal input or an external clock
System Control & Clocks | OSC1 | 41 | O | Analog | reference input. Main oscillator crystal output. Leave unconnected
 |  |  |  |  | when using a single-ended clock source.
 | RST | 38 | I | TTL | System reset input.

Sheet: page 20
 | Function | Pin Name | Pin Number | Pin Type | Buffer Typea | Description
 |  | U0Rx | 17 | I | TTL | UART module 0 receive.
 |  | U0Tx | 18 | O | TTL | UART module 0 transmit.
 |  | U1CTS | 15 | I | TTL | UART module 1 Clear To Send modem flow control
 |  |  | 29 |  |  | input signal.
 |  | U1RTS | 16 | O | TTL | UART module 1 Request to Send modem flow
 |  |  | 28 |  |  | control output line.
 |  | U1Rx | 16 | I | TTL | UART module 1 receive.
 |  |  | 45
 |  | U1Tx | 15 | O | TTL | UART module 1 transmit.
 |  |  | 46
 |  | U2Rx | 53 | I | TTL | UART module 2 receive.
UART |  | U2Tx | 10 | O | TTL | UART module 2 transmit.
 |  | U3Rx | 14 | I | TTL | UART module 3 receive.
 |  | U3Tx | 13 | O | TTL | UART module 3 transmit.
 |  | U4Rx | 16 | I | TTL | UART module 4 receive.
 |  | U4Tx | 15 | O | TTL | UART module 4 transmit.
 |  | U5Rx | 59 | I | TTL | UART module 5 receive.
 |  | U5Tx | 60 | O | TTL | UART module 5 transmit.
 |  | U6Rx | 43 | I | TTL | UART module 6 receive.
 |  | U6Tx | 44 | O | TTL | UART module 6 transmit.
 |  | U7Rx | 9 | I | TTL | UART module 7 receive.
 |  | U7Tx | 8 | O | TTL | UART module 7 transmit.
 |  | USB0DM | 43 | I/O | Analog | Bidirectional differential data pin (D- per USB
 |  |  |  |  |  | specification) for USB0.
 |  | USB0DP | 44 | I/O | Analog | Bidirectional differential data pin (D+ per USB
 |  |  |  |  |  | specification) for USB0.
 |  | USB0EPEN | 5 | O | TTL | Optionally used in Host mode to control an external
 |  |  | 14 |  |  | power source to supply power to the USB bus.
 |  |  | 63
 |  | USB0ID | 45 | I | Analog | This signal senses the state of the USB ID signal.
USB |  |  |  |  |  | The USB PHY enables an integrated pull-up, and an external element (USB connector) indicates the
 |  |  |  |  |  | initial state of the USB controller (pulled down is
 |  |  |  |  |  | the A side of the cable and pulled up is the B side).
 |  | USB0PFLT | 13 | I | TTL | Optionally used in Host mode by an external power
 |  |  | 64 |  |  | source to indicate an error state by that power
 |  |  |  |  |  | source.
 |  | USB0VBUS | 46 | I/O | Analog | This signal is used during the session request
 |  |  |  |  |  | protocol. This signal allows the USB PHY to both
 |  |  |  |  |  | sense the voltage level of VBUS, and pull up VBUS
 |  |  |  |  |  | momentarily during VBUS pulsing.

Sheet: page 21
Analog Digital Function (GPIOPCTL PMCx Bit Field Encoding)a IO Pin Function 1 2 3 4 5 6 7 8 9 14 15
PA0 17 - PA1 18 - |  |  |  | U0Rx U0Tx |  | - - - - - - CAN1Rx - - - - - - - - - CAN1Tx - - -
PA2 19 - - PA3 20 - - PA4 21 - - PA5 22 - - |  |  |  |  |  | SSI0Clk SSI0Fss SSI0Rx SSI0Tx |  | - - - - - - - - - - - - - - - - - - - - - - - - - - - - - - - - - - - -
PB0 | 45 | USB0ID | U1Rx |  | - |  | - |  | - | - - T2CCP0 |  | - | - - -
PB1 | 46 | USB0VBUS | U1Tx |  | - |  | - |  | - | - - T2CCP1 |  | - | - - -
PB2 | 47 | - | - |  | - |  | I2C0SCL |  | - | - - T3CCP0 |  | - | - - -
PB3 | 48 | - | - |  | - |  | I2C0SDA |  | - | - - T3CCP1 |  | - | - - -
PB4 | 58 | AIN10 | - |  | SSI2Clk |  | - |  | M0PWM2 | - - T1CCP0 |  | CAN0Rx | - - -
PB5 | 57 | AIN11 | - |  | SSI2Fss |  | - |  | M0PWM3 | - - T1CCP1 |  | CAN0Tx | - - -
PB6 | 1 | - | - |  | SSI2Rx |  | - |  | M0PWM0 | - - T0CCP0 |  | - | - - -
PB7 | 4 | - | - |  | SSI2Tx |  | - |  | M0PWM1 | - - T0CCP1 |  | - | - - -
PC0 | 52 | - | TCK SWCLK |  | - |  | - - |  |  | - - | T4CCP0 | - | - - -
PC1 | 51 | - | TMS SWDIO |  | - |  | - - |  |  | - - | T4CCP1 | - | - - -
PC2 | 50 | - | TDI |  | - |  | - - |  |  | - - | T5CCP0 | - | - - -
PC3 | 49 | - | TDO SWO |  | - |  | - - |  |  | - - | T5CCP1 | - | - - -
PC4 | 16 | C1- | U4Rx |  | U1Rx |  | - M0PWM6 |  |  | - IDX1 | WT0CCP0 | U1RTS | - - -
PC5 | 15 | C1+ | U4Tx |  | U1Tx |  | - M0PWM7 |  |  | - PhA1 | WT0CCP1 | U1CTS | - - -
PC6 | 14 | C0+ | U3Rx |  | - |  | - - |  |  | - PhB1 | WT1CCP0 | USB0EPEN | - - -
PC7 | 13 | C0- | U3Tx |  | - |  | - - |  |  | - - | WT1CCP1 | USB0PFLT | - - -
PD0 | 61 | AIN7 | SSI3Clk |  | SSI1Clk |  | I2C3SCL M0PWM6 |  |  | M1PWM0 - | WT2CCP0 | - | - - -
PD1 | 62 | AIN6 | SSI3Fss |  | SSI1Fss |  | I2C3SDA M0PWM7 |  |  | M1PWM1 - | WT2CCP1 | - | - - -
PD2 | 63 | AIN5 | SSI3Rx |  | SSI1Rx |  | - M0FAULT0 |  |  | - - | WT3CCP0 | USB0EPEN | - - -
PD3 | 64 | AIN4 | SSI3Tx |  | SSI1Tx |  | - - |  |  | - IDX0 | WT3CCP1 | USB0PFLT | - - -
PD4 | 43 | USB0DM | U6Rx |  | - |  | - - |  |  | - - | WT4CCP0 | - | - - -
PD5 | 44 | USB0DP | U6Tx |  | - |  | - - |  |  | - - | WT4CCP1 | - | - - -
PD6 | 53 | - | U2Rx |  | - |  | - M0FAULT0 |  |  | - PhA0 | WT5CCP0 | - | - - -
PD7 | 10 | - | U2Tx |  | - |  | - - |  |  | - PhB0 | WT5CCP1 | NMI | - - -
PE0 | 9 | AIN3 | U7Rx |  | - |  | - - |  |  | - - | - | - | - - -
PE1 | 8 | AIN2 | U7Tx |  | - |  | - - |  |  | - - | - | - | - - -
PE2 | 7 | AIN1 | - |  | - |  | - - |  |  | - - | - | - | - - -
PE3 | 6 | AIN0 | - |  | - |  | - - |  |  | - - | - | - | - - -
