antmerlino/Micromouse/Hardware/BOM.ods

Schematic | Designator | Value | Footprint | Description | Vendor | Manufacturer | Part Number | URL
IMU | C1 | 0.01uF | 0603 | Decoupling Input Capacitor | Digikey
Controller Power | C22,C24,C26 | 0.01uF | 0603 | Decoupling Input Capacitor | Digikey
Motor Control | C13 | 0.1uF | 0603 | Decoupling Input Capacitor | Digikey
Motor Control | C15 | 0.1uF | 0603 | Decoupling Motor Supply Capacitor | Digikey
Battery Charger | C17 | 0.1uF | 0603 | Decoupling Input Capacitor | Stock | - | - | -
IMU | C2 | 0.1uF | 0603 | Decoupling Input Capacitor | Digikey
Controller Power | C21 | 0.1uF | 0603 | Decoupling Capacitor – Reset
Controller Power | C23,C25 | 0.1uF | 0603 | VDD – Decoupling Capacitor | Digikey
Controller Power | C29,C30 | 0.1uF | 0603 | VDDC – Decoupling Capacitor | Digikey
IMU | C3 | 0.1uF | 0603 | REGOUT Capacitor | Digikey
Power Regulation | C35 | 0.1uF | 0603 | Decoupling Input Capacitor | Stock | - | - | -
IR Receivers | C5-C12 | 0.1uF | 0603 | Decoupling Output Capacitor | Digikey
Battery Charger | C19 | 0.47uF | 0603 | Compensation Capacitor | Digikey | Kemet | C0603C474K9RACTU | http://www.digikey.com/product-detail/en/C0603C474K9RACTU/399-4924-1-ND/1090919
Controller Power | C32,C33 | 10pF | 0603 | Capacitor for XTAL | Digikey
Motor Control | C14 | 10uF | 0603 | Bulk Input Capacitor | Digikey
Motor Control | C16 | 10uF | 1210 | Bulk Motor Supply Capacitor | Digikey
Battery Charger | C18 | 10uF | 1210 | Bulk Input Capacitor | Digikey | Taiyo Yuden | TMK325BJ106MM-T
Power Regulation | C34 | 10uF | 0603 | Bulk Input Capacitor | Stock | - | - | -
Controller Power | C27 | 1uF | 0603 | VDD – Bulk Capacitor | Digikey
Controller Power | C31 | 1uF | 0603 | VDDC – Bulk Capacitor | Digikey
IMU | C4 | 2.2nF | 0603 | CPOUT Capacitor | Digikey
Controller Power | C28 | 2.2uF | 0603 | VDDC – Bulk Capacitor | Digikey
Battery Charger | C20 | 22uF | 1210 | Output Capacitor | Digikey | Taiyo Yuden | JMK325BJ226MM-T
Power Regulation | C36 | 22uF | 0603 | Bulk Output Capacitor | Stock | - | - | -
IR Emitters | D1-D7 |  |  | IR LED | Digikey | Vishay Semiconductor | TSAL6100 | http://www.digikey.com/product-detail/en/0/751-1203-ND
Status LED | D10 |  |  | Status LED | Digikey | Biva Inc. | SM1210RGB | http://www.digikey.com/product-detail/en/SM1210RGB/492-1243-1-ND/2404534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
Battery Charger | D11 |  |  | Protection Diode for Transistor? | Digikey | Diodes Inc. | B330B-13-F
Battery Charger | D12 |  |  | Charge Indication LED | Digikey | Lite-On | LTST-C191TBKT | http://www.digikey.com/product-detail/en/LTST-C191TBKT/160-1647-2-ND/388530
Power Regulation | D13 | 3.9V |  | Zener Diode | Digikey | Vishay Semiconductor | BZG05C3V9TR | http://www.digikey.com/product-detail/en/BZG05C3V9TR/BZG05C3V9CT-ND/3104446
Power Regulation | D14 |  |  | Power Indication LED | Digikey | Lite-On | LTST-C191KRKT
Power Regulation | F1 |  |  | Protection for components on 3.3V Bus | Digikey | Bourns Inc. | MF-FSMF050X-2 | http://www.digikey.com/product-detail/en/MF-FSMF050X-2/MF-FSMF050X-2TR-ND/2039256
IR Receivers | IR1-IR8 |  |  | IR Receiver | Digikey | AMS-TAOS | TSL262R | http://www.digikey.com/product-detail/en/0/TSL262-R-LF-ND
Battery Charger | J1 |  |  | DC Power Jack | Sparkfun | - | - | https://www.sparkfun.com/products/10811
Battery Charger | L1 | 22uH |  | Inductor to stabilize charge current | Digikey | Abracon Corp. | ASPI-6045S-220M-T | http://www.digikey.com/product-detail/en/ASPI-6045S-220M-T/ASPI-6045S-220M-TCT-ND/3060385
Battery Charger | P? |  |  | 2-Pos Header for NTC | Stock | - | - | -
Motor Control | P2-P3 |  |  | Motor Connector | Pololu | - | - | http://www.pololu.com/product/854
Battery Charger | P4-P5 |  |  | JST Connector for Battery | Sparkfun | 4UCON | PRT-08613 | https://www.sparkfun.com/products/8613
IR Emitters | Q1-Q6 |  |  | Pre-biased transistor for LED control | Digikey | Rohm Semiconductor | DTD743EETL | http://www.digikey.com/product-detail/en/0/DTD743EETLCT-ND
Battery Charger | Q10 |  |  | Dual P-Channel MOSFET for Switching | Digikey | Vishay Siliconix | SI9933CDY-T1-GE3 | http://www.digikey.com/product-detail/en/SI9933CDY-T1-GE3/SI9933CDY-T1-GE3CT-ND/1979012
Status LED | Q7-Q9 |  |  | Pre-biased transistor for LED control | Digikey | Rohm Semiconductor | DTD743EETL | http://www.digikey.com/product-detail/en/0/DTD743EETLCT-ND
Controller Power | R23 | 0ohm | 0603 | Jumper Resistor for External XTAL | Digikey
Battery Charger | R14 | 100k | 0603 | Pull-up resistor for Vin | Stock | - | - | -
Controller Peripherals | R18-R21 | 100k | 0603 | Pullup/Pulldown for JTAG | Digikey
IR Receivers | R3-R10 | 100k | 0603 | Receiver Resistor | Digikey
IMU | R1 | 10k | 0603 | SCL Pullup | Digikey
IMU | R2 | 10k | 0603 | SDA Pullup
Controller Power | R22 | 10k | 0603 | Reset Pullup
Battery Charger | R15 | 110m | 0603 | Sense Resistor for sensing max charge current | Digikey
Status LED | R11-R13 | 120ohm | 0603 | Limiting Resistor | Digikey
Battery Charger | R17 | 1k | 0603 | Series LED resistor | Stock | - | - | -
Battery Charger | R16 | 2.2k | 0603 | Compensation Resistor | Digikey
Power Regulation | R24 | 500ohm | 0603 | Series LED resistor | Stock | - | - | -
Controller Power | S1 |  | 0603 | Reset Switch | Digikey
Controller Peripherals | S2 |  | 0603 | Mode Switch | Digikey
IMU | U1 |  |  | MPU9150 | Digikey | InvenSense | MPU9150 | http://www.digikey.com/product-detail/en/MPU-9150/1428-1009-6-ND/4038015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
Motor Control | U2 |  |  | Motor Controller | Digikey | Toshiba Semiconductor | TB6612FNG | http://www.digikey.com/product-detail/en/TB6612FNG(O%2cC%2c8%2cEL/TB6612FNG(OC8EL)CT-ND/1730134?itemSeq=145951311&uq=635299722097857118
Battery Charger | U3 |  |  | Battery Charging IC | Digikey | Linear Technology | LTC4002ES8-8.4#PBF | http://www.digikey.com/product-detail/en/LTC4002ES8-8.4%23PBF/LTC4002ES8-8.4%23PBF-ND/962654
Controller Power | U4 |  |  | Microcontroller | Digikey
Power Regulation | VR1 |  |  | 3.3V LDO Regulator | Digikey | Diodes Inc. | AP1117E33G-13
Controller Power | Y1 |  |  | 16MHz Oscillator | Digikey | Abracon | ABM3-16.000MHZ-B2-T | http://www.digikey.com/product-detail/en/ABM3-16.000MHZ-B2-T/535-9103-1-ND/675620
