antmerlino/Micromouse/Mechanical/micromouse.SLDASM

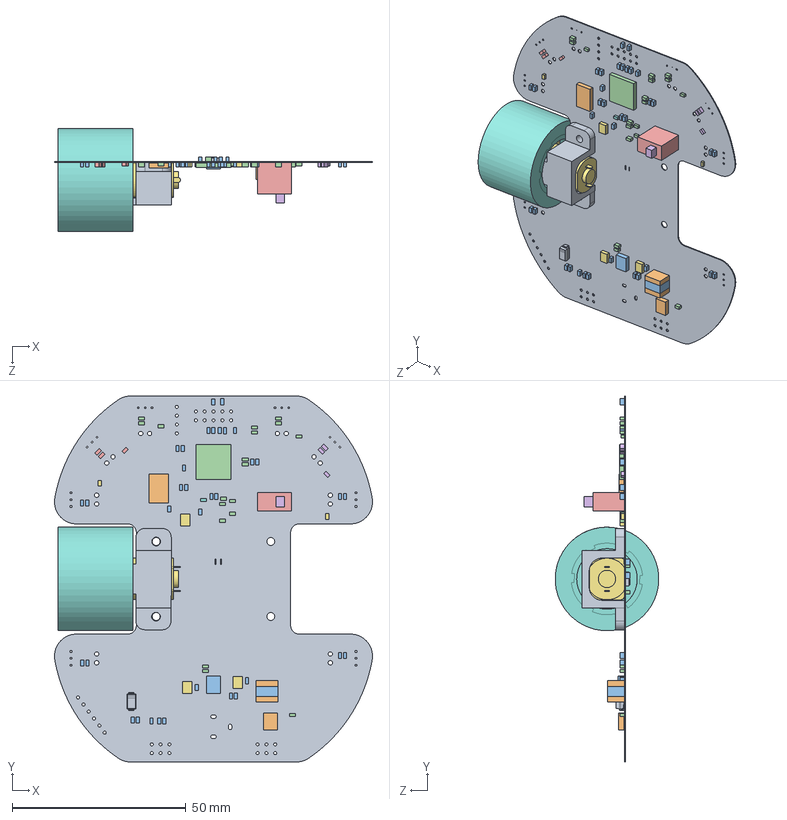
[picture p2: CAD file, 2014-03-19]
Mechanical/micromouse.SLDASM
91.6 x 105.4 x 29.8 mm
Board
Extruded
Extruded_2 x 39
Extruded_3 x 16
Extruded_4 x 2
Extruded_5 x 2
Extruded_6 x 3
User_Library-0603_SMD_Capacitor x 26
SW3dPS-DO-214AC_SMA
Extruded_7 x 2
Extruded_8
Extruded_9 x 4
Extruded_10
Extruded_11
Extruded_12 x 2
Extruded_13
Extruded_14
Extruded_15
Extruded_16
Extruded_17
Extruded_18
Extruded_19
Pololu - 1_250 Micro gear motor
cobra_wheels
motor_mount_rev2
