antmerlino/Micromouse/Mechanical/Board_Outline/rub_strip.dxf

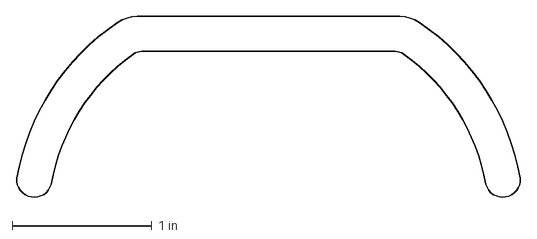
[picture p3: CAD file, 2014-03-22]
Mechanical/Board_Outline/rub_strip.dxf
3.61 x 1.30 in
