antmerlino/Micromouse/Mechanical/FreeCAD/PCB.FCStd

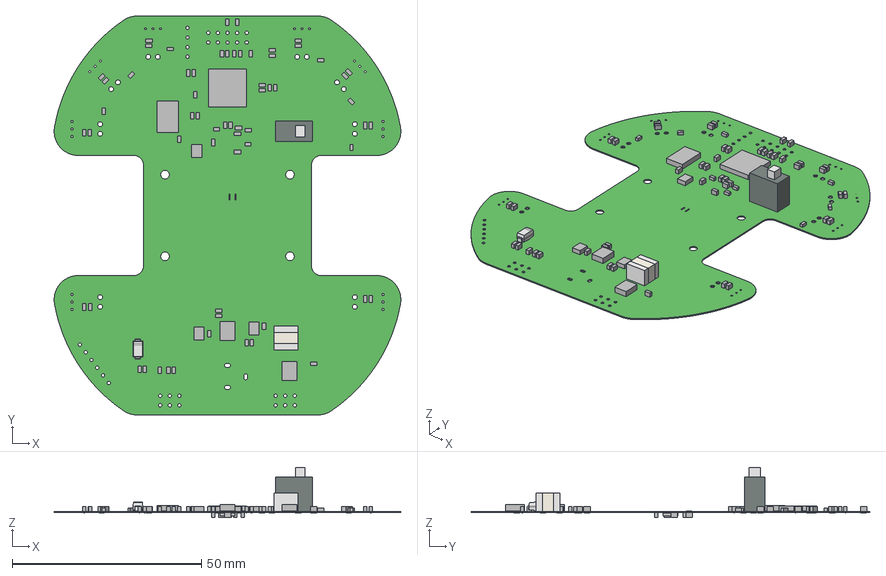
[picture p4: CAD file, 2014-03-19]
Mechanical/FreeCAD/PCB.FCStd
91.6 x 105.4 x 13.2 mm
Board
Extruded
Extruded001
Extruded002
Extruded003
Extruded004
Extruded005
Extruded006
Extruded007
Extruded008
Extruded009
Extruded010
Extruded011
Extruded012
Extruded013
Extruded014
Extruded015
Extruded016
Extruded017
Extruded018
Extruded019
Extruded020
Extruded021
Extruded022
Extruded023
Extruded024
Extruded025
Extruded026
Extruded027
Extruded028
Extruded029
Extruded030
Extruded031
Extruded032
Extruded033
Extruded034
Extruded035
Extruded036
User_Library-0603_SMD_Capacitor
Extruded037
SW3dPS-DO-214AC_SMA
User_Library-0603_SMD_Capacitor001
Extruded038
Extruded039
Extruded040
Extruded041
Extruded042
Extruded043
Extruded044
Extruded045
Extruded046
Extruded047
Extruded048
Extruded049
Extruded050
User_Library-0603_SMD_Capacitor002
Extruded051
User_Library-0603_SMD_Capacitor003
Extruded052
User_Library-0603_SMD_Capacitor004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
