antmerlino/Micromouse/Mechanical/IR_blokc.SLDPRT

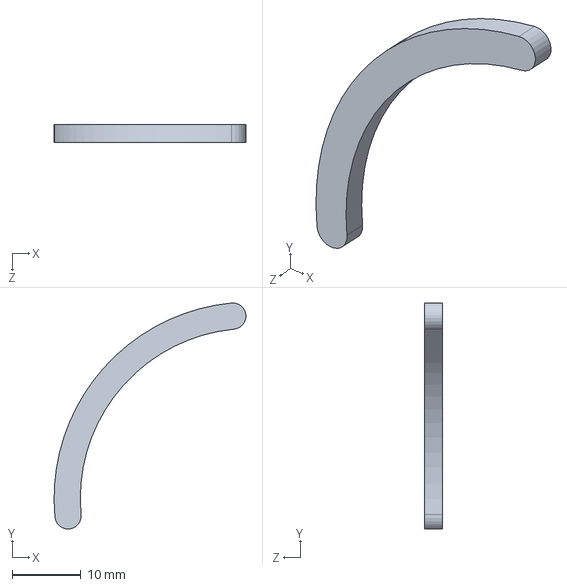
[picture p5: CAD file, 2014-03-22]
Mechanical/IR_blokc.SLDPRT
27.8 x 32.8 x 2.54 mm
