antmerlino/Micromouse/Mechanical/Board_Outline/ground_plane_outline.dxf

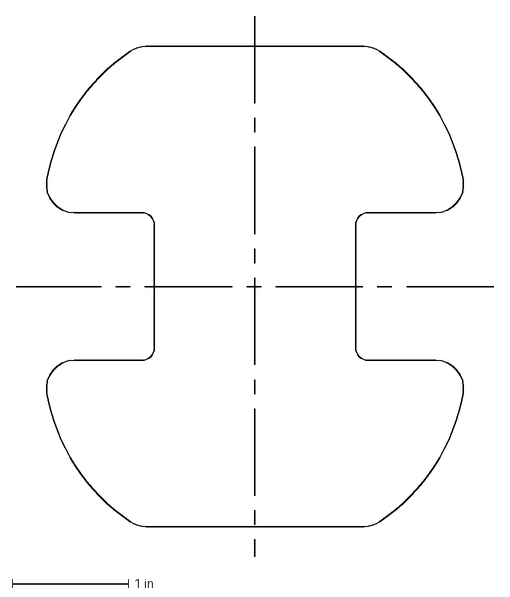
[picture p6: CAD file, 2014-03-19]
Mechanical/Board_Outline/ground_plane_outline.dxf
4.11 x 4.65 in
