antmerlino/Micromouse/Mechanical/FreeCAD/Motor.FCStd

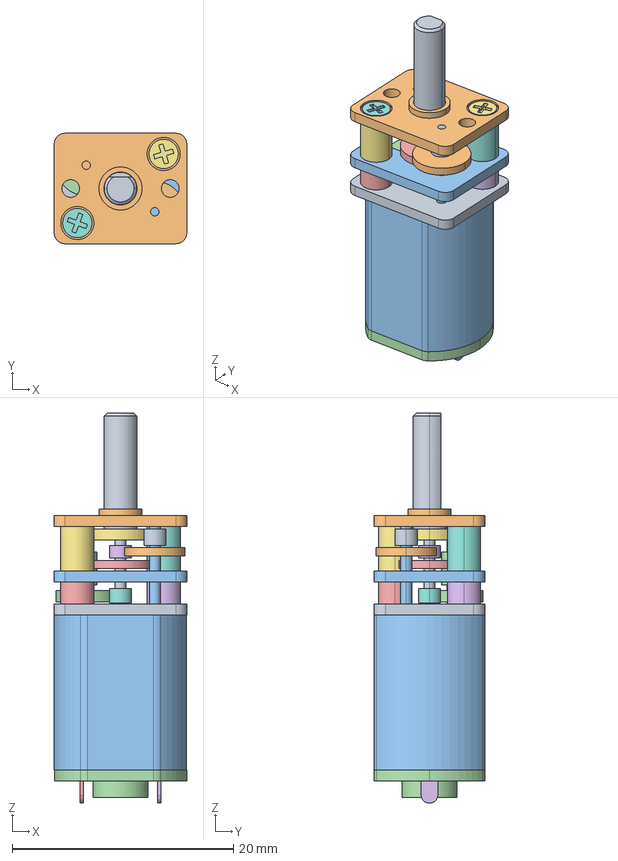
[picture p7: CAD file, 2014-03-19]
Mechanical/FreeCAD/Motor.FCStd
12.0 x 10.0 x 35.3 mm
Pololu - 1_250 Micro gear motor
Pololu - 1_250 Micro gear motor001
Pololu - 1_250 Micro gear motor002
Pololu - 1_250 Micro gear motor003
Pololu - 1_250 Micro gear motor004
Pololu - 1_250 Micro gear motor005
Pololu - 1_250 Micro gear motor006
Pololu - 1_250 Micro gear motor007
Pololu - 1_250 Micro gear motor008
Pololu - 1_250 Micro gear motor009
Pololu - 1_250 Micro gear motor010
Pololu - 1_250 Micro gear motor011
Pololu - 1_250 Micro gear motor012
Pololu - 1_250 Micro gear motor013
Pololu - 1_250 Micro gear motor014
Pololu - 1_250 Micro gear motor015
Pololu - 1_250 Micro gear motor016
Pololu - 1_250 Micro gear motor017
Pololu - 1_250 Micro gear motor018
Pololu - 1_250 Micro gear motor019
Pololu - 1_250 Micro gear motor020
Pololu - 1_250 Micro gear motor021
Pololu - 1_250 Micro gear motor022
Pololu - 1_250 Micro gear motor023
