antmerlino/Micromouse/Mechanical/Board_Outline/board_rev1.1.dxf

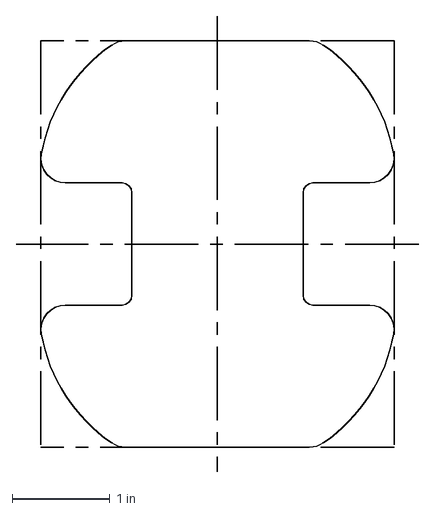
[picture p8: CAD file, 2014-03-19]
Mechanical/Board_Outline/board_rev1.1.dxf
4.11 x 4.65 in
