antmerlino/Micromouse/Mechanical/motor_mount_rev2.SLDPRT

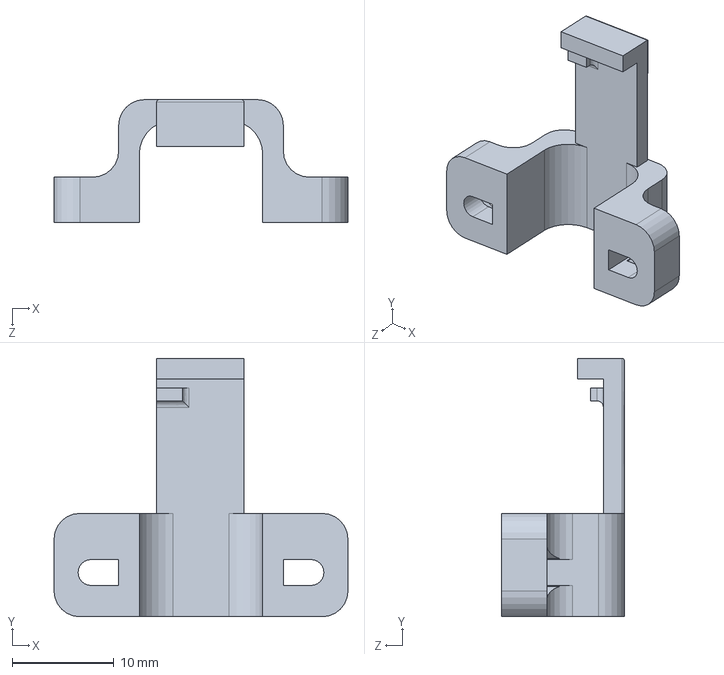
[picture p9: CAD file, 2014-03-19]
Mechanical/motor_mount_rev2.SLDPRT
28.9 x 25.4 x 12.1 mm
