antmerlino/Micromouse/Mechanical/cobra_wheels.SLDPRT

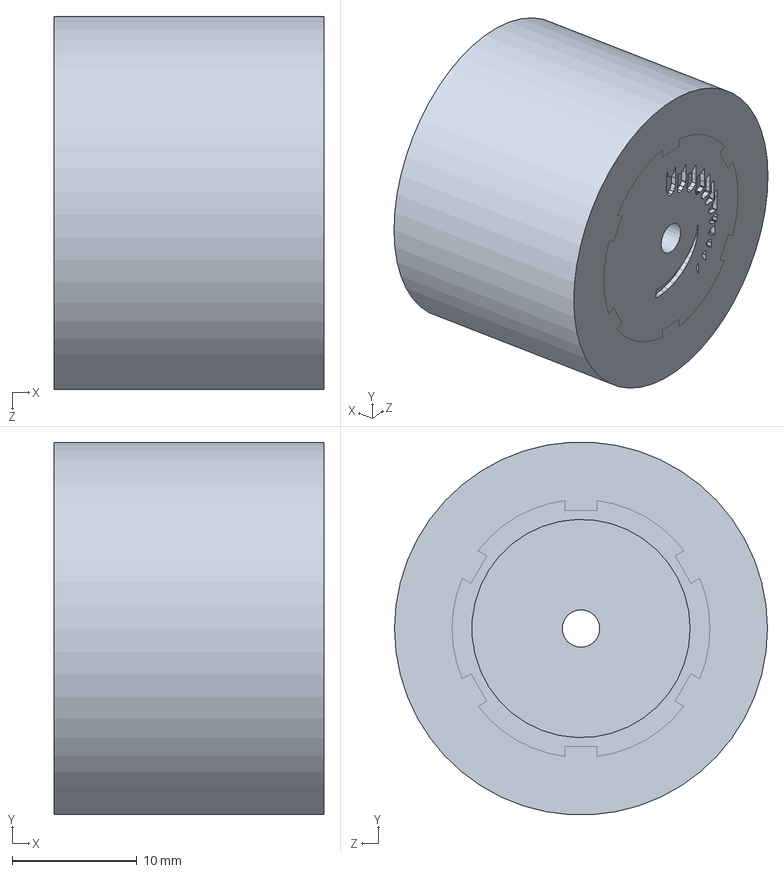
[picture p10: CAD file, 2014-03-19]
Mechanical/cobra_wheels.SLDPRT
21.6 x 29.8 x 29.8 mm
