antmerlino/Micromouse/(list of files, cad)

Other CAD files:
Mechanical/PCB/Q6.sldasm
Mechanical/PCB/C8.sldasm
Software/micromouse/src/sysbios/m3_Hwi_asm.obj
Mechanical/PCB/C5.sldasm
Software/micromouse/src/sysbios/ducati_Core_asm.obj
Software/micromouse/src/sysbios/m3_Clobber_asm.obj
Software/micromouse/src/sysbios/ducati_CTM_asm.obj
Software/micromouse/src/sysbios/dmtimer_Timer_asm.obj
Software/micromouse/src/sysbios/m3_IntrinsicsSupport_asm.obj
Mechanical/PCB/R21.sldasm
Software/micromouse/src/sysbios/m3_TaskSupport_asm.obj
Software/micromouse/src/sysbios/m3_Hwi_asm_switch.obj
Mechanical/PCB/C17.sldasm
Mechanical/PCB/C13.sldasm
Mechanical/PCB/Q10.sldasm
Mechanical/PCB/R12.sldasm
Mechanical/PCB/R20.sldasm
Mechanical/PCB/R4.sldasm
Mechanical/PCB/C12.sldasm
Mechanical/PCB/Q3.sldasm
Mechanical/PCB/Q9.sldasm
Mechanical/PCB/C6.sldasm
Mechanical/PCB/C34.sldasm
Mechanical/PCB/C27.sldasm
Mechanical/PCB/R17.sldasm
Mechanical/PCB/R10.sldasm
Mechanical/PCB/Q7.sldasm
Mechanical/PCB/R7.sldasm
Mechanical/PCB/C18.sldasm
Mechanical/PCB/R15.sldasm
Mechanical/PCB/U4.sldasm
Mechanical/PCB/R5.sldasm
Mechanical/PCB/D13.sldasm
Mechanical/PCB/R23.sldasm
Mechanical/PCB/Q5.sldasm
Mechanical/PCB/C31.sldasm
Mechanical/PCB/U1.sldasm
Mechanical/PCB/C20.sldasm
Mechanical/PCB/R24.sldasm
Mechanical/PCB/C9.sldasm
Mechanical/PCB/C24.sldasm
Mechanical/PCB/R14.sldasm
Mechanical/PCB/C26.sldasm
Mechanical/PCB/U3.sldasm
Mechanical/PCB/S2.sldasm
Mechanical/PCB/R9.sldasm
Mechanical/PCB/C4.sldasm
Mechanical/PCB/C23.sldasm
Mechanical/PCB/L1.sldasm
Mechanical/PCB/Q4.sldasm
Mechanical/PCB/R11.sldasm
Mechanical/PCB/C22.sldasm
Mechanical/PCB/Q8.sldasm
Mechanical/PCB/Q1.sldasm
Mechanical/PCB/C28.sldasm
Mechanical/PCB/Q2.sldasm
Mechanical/PCB/C36.sldasm
Mechanical/PCB/C25.sldasm
Mechanical/PCB/R18.sldasm
Mechanical/PCB/D12.sldasm
Mechanical/PCB/R19.sldasm
Mechanical/PCB/C16.sldasm
Mechanical/PCB/C29.sldasm
Mechanical/PCB/R2.sldasm
Mechanical/PCB/D14.sldasm
Mechanical/PCB/C21.sldasm
Mechanical/PCB/C32.sldasm
Mechanical/PCB/C35.sldasm
Mechanical/PCB/R22.sldasm
Mechanical/PCB/C1.sldasm
Mechanical/PCB/R8.sldasm
Mechanical/PCB/C19.sldasm
Mechanical/PCB/C15.sldasm
Mechanical/PCB/C33.sldasm
Mechanical/PCB/C3.sldasm
Mechanical/PCB/R16.sldasm
Mechanical/PCB/C10.sldasm
Mechanical/PCB/C7.sldasm
Mechanical/PCB/C30.sldasm
Mechanical/PCB/R1.sldasm
Mechanical/PCB/R13.sldasm
Mechanical/PCB/R6.sldasm
Mechanical/PCB/R3.sldasm
Mechanical/PCB/C2.sldasm
Mechanical/PCB/C14.sldasm
Mechanical/PCB/C11.sldasm
Mechanical/PCB/U2.sldasm
Hardware/micromouse.DWG
Software/micromouse/src/sysbios/BIOS.obj
Mechanical/Pololu - 1_250 Micro gear motor.SLDPRT
Mechanical/PCB/User_Library-0603_SMD_Capacitor.sldprt
Mechanical/motor_mount_rev3.STL
Mechanical/PCB/Extruded_2.sldprt
Software/micromouse/src/sysbios/smp_Power_saveCpu.obj
Software/micromouse/src/sysbios/smp_Power_resumeCpu.obj
Mechanical/PCB/Extruded.sldprt
Software/micromouse/src/sysbios/omap4430_Power_resumeCpu.obj
Mechanical/PCB/Extruded_6.sldprt
Software/micromouse/src/sysbios/omap4430_Power_saveCpu.obj
Mechanical/PCB/SW3dPS-DO-214AC_SMA.sldprt
Mechanical/PCB/Extruded_8.sldprt
Mechanical/PCB/Extruded_19.sldprt
Mechanical/PCB/Extruded_15.sldprt
Mechanical/PCB/pcb.step
Mechanical/PCB/Extruded_11.sldprt
Mechanical/PCB/Extruded_14.sldprt
Mechanical/PCB/Extruded_18.sldprt
Mechanical/PCB/Extruded_7.sldprt
Mechanical/PCB/Extruded_16.sldprt
Mechanical/PCB/Extruded_4.sldprt
Mechanical/PCB/Extruded_13.sldprt
Mechanical/PCB/Extruded_9.sldprt
Mechanical/PCB/Extruded_17.sldprt
Mechanical/PCB/Extruded_3.sldprt
Mechanical/PCB/Extruded_10.sldprt
Mechanical/PCB/Extruded_5.sldprt
Mechanical/PCB/Extruded_12.sldprt
Mechanical/PCB/Board.sldprt
Mechanical/Board_Outline/board_rev1.0.dwg
Mechanical/Board_Outline/board_rev1.0.dxf
Mechanical/Board_Outline/board_rev1.1.dwg
Mechanical/Board_Outline/rub_strip.dwg
Mechanical/PCB/700809344.sldasm
Mechanical/PCB/700809600.sldasm
Mechanical/PCB/700810240.sldasm
Mechanical/PCB/700810368.sldasm
Mechanical/PCB/700810496.sldasm
Mechanical/PCB/700810624.sldasm
Mechanical/PCB/700810752.sldasm
Mechanical/PCB/700811008.sldasm
Mechanical/PCB/700811264.sldasm
Mechanical/PCB/700811392.sldasm
Mechanical/PCB/700811520.sldasm
Mechanical/PCB/700811648.sldasm
Mechanical/PCB/700811776.sldasm
Mechanical/PCB/700811904.sldasm
Mechanical/PCB/700812032.sldasm
Mechanical/PCB/700812288.sldasm
Mechanical/PCB/700812416.sldasm
Mechanical/PCB/700812544.sldasm
Mechanical/PCB/700812672.sldasm
Mechanical/PCB/pcb.SLDASM
Mechanical/motor_mount_rev2.STL
