antmerlino/Micromouse/Hardware/micromouse.pdf

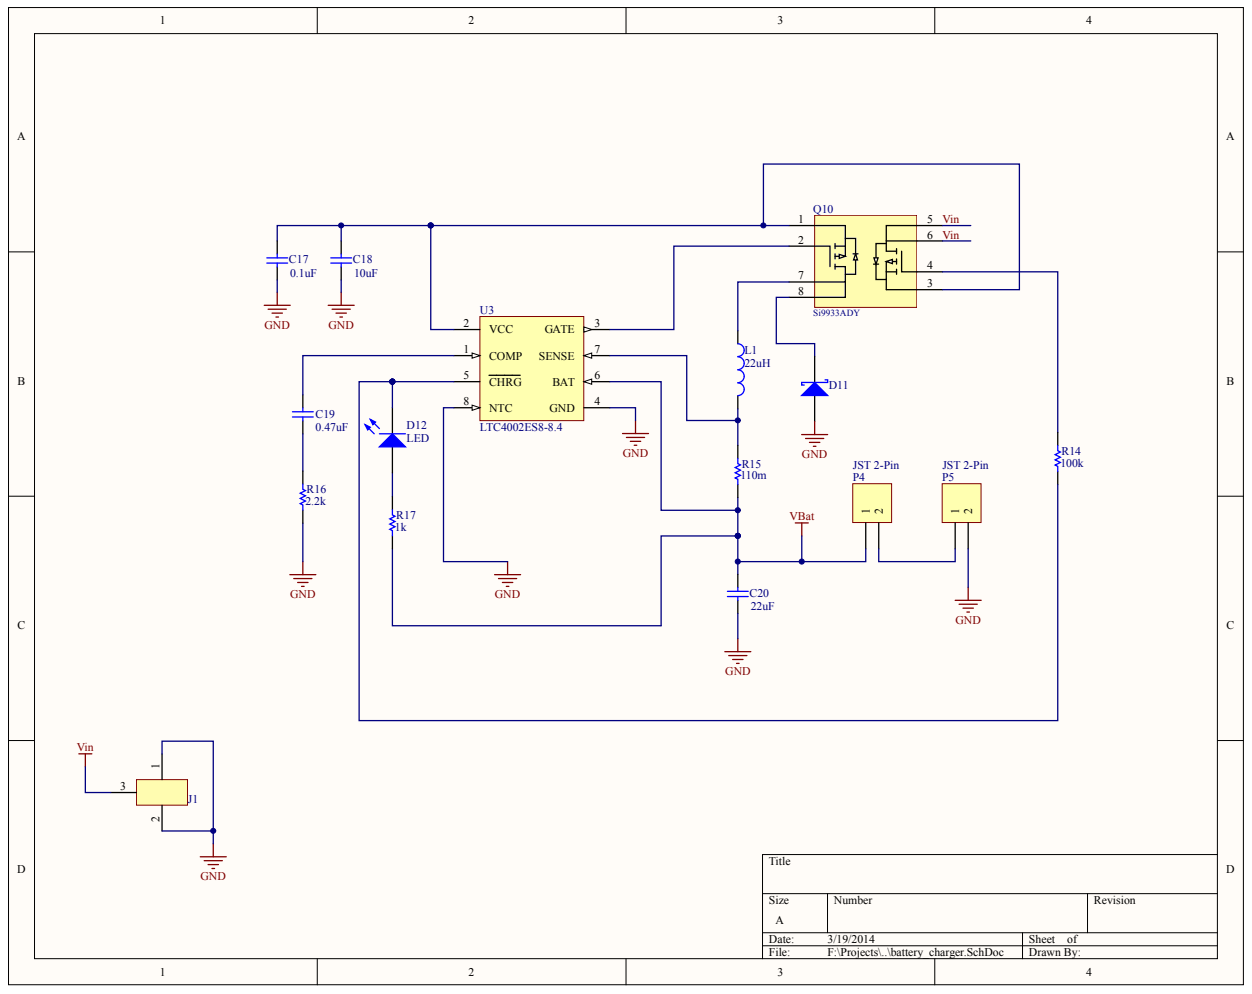
[picture p11: page 1]

8 | CHRG NTC | 4 | R15 JST 2-Pin 110m P4

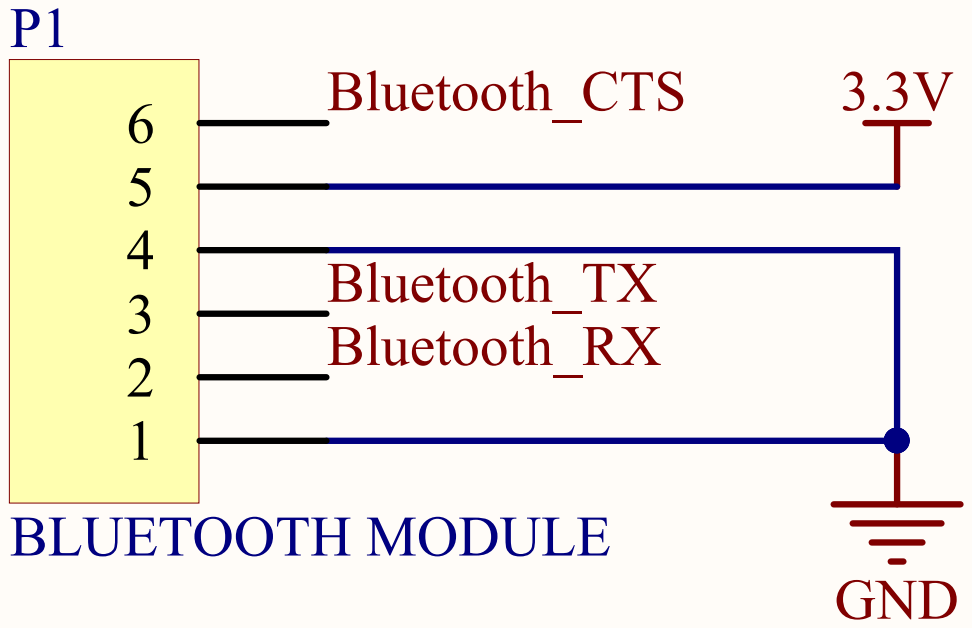
[picture p12: page 2]

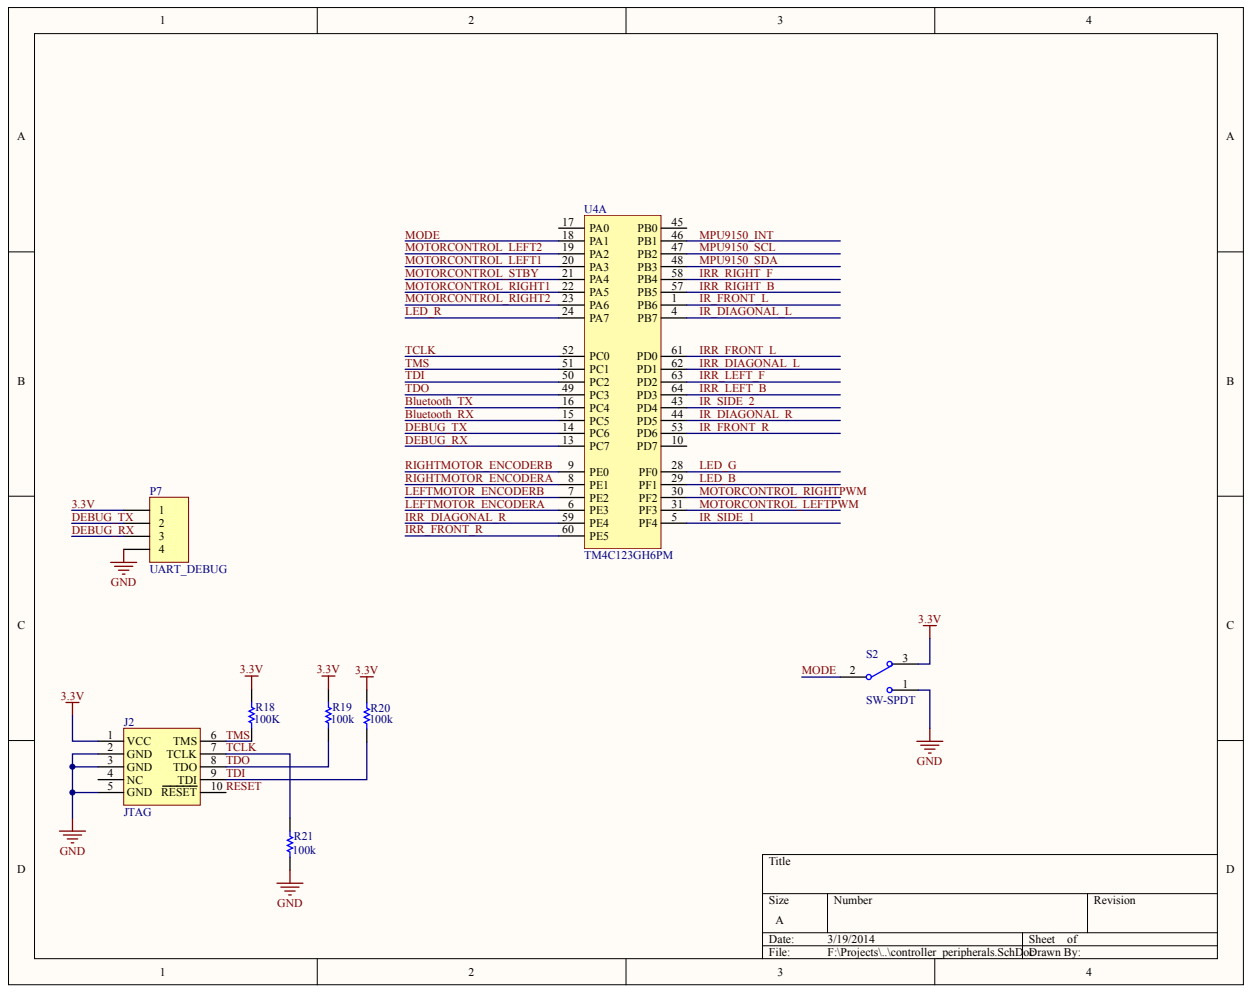
[picture p13: page 3]

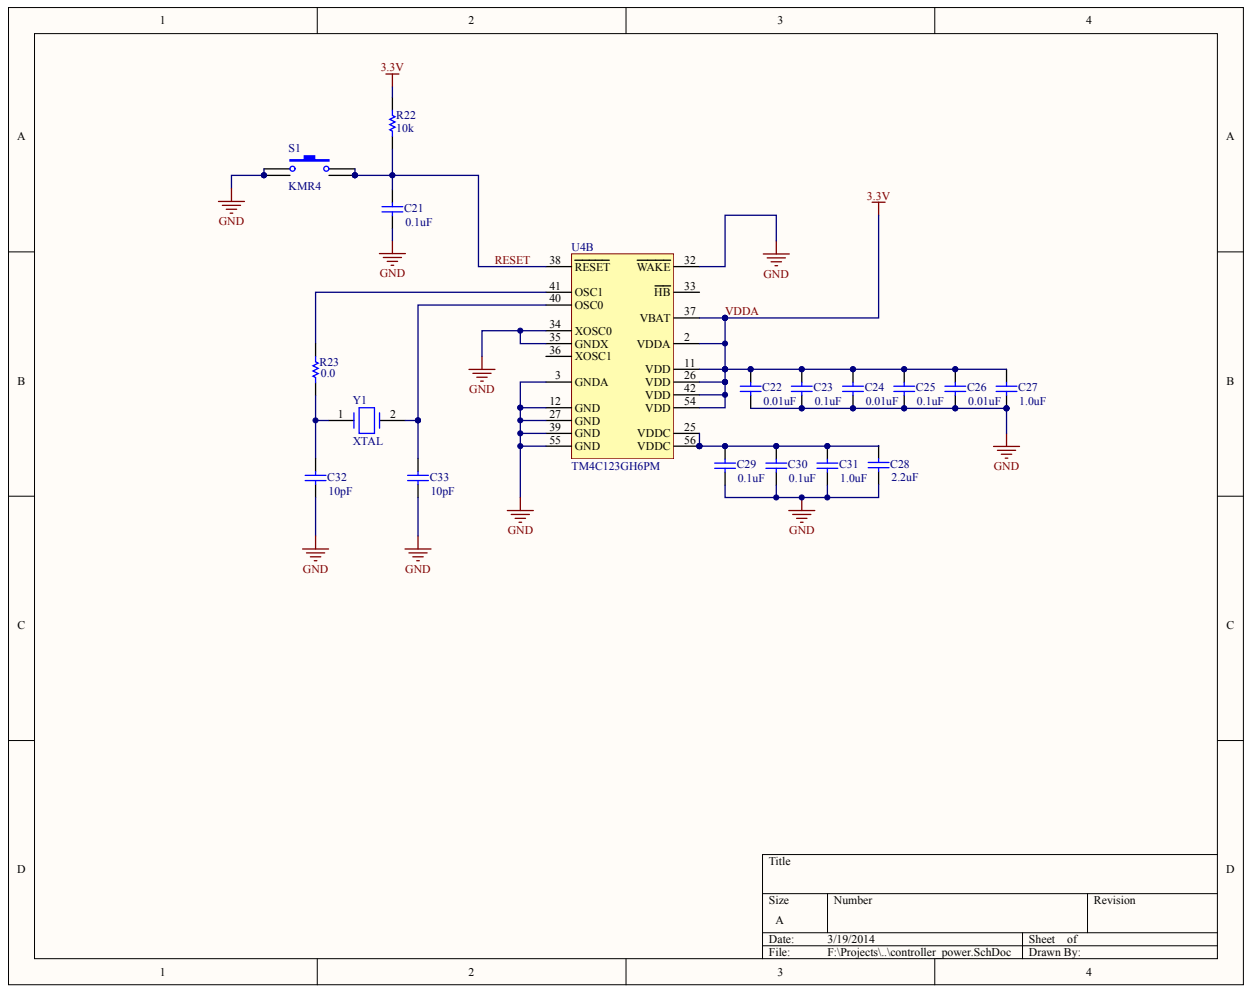
[picture p14: page 4]

XOSC0 34
GNDX 35
XOSC1 36

GND 12

GND 39

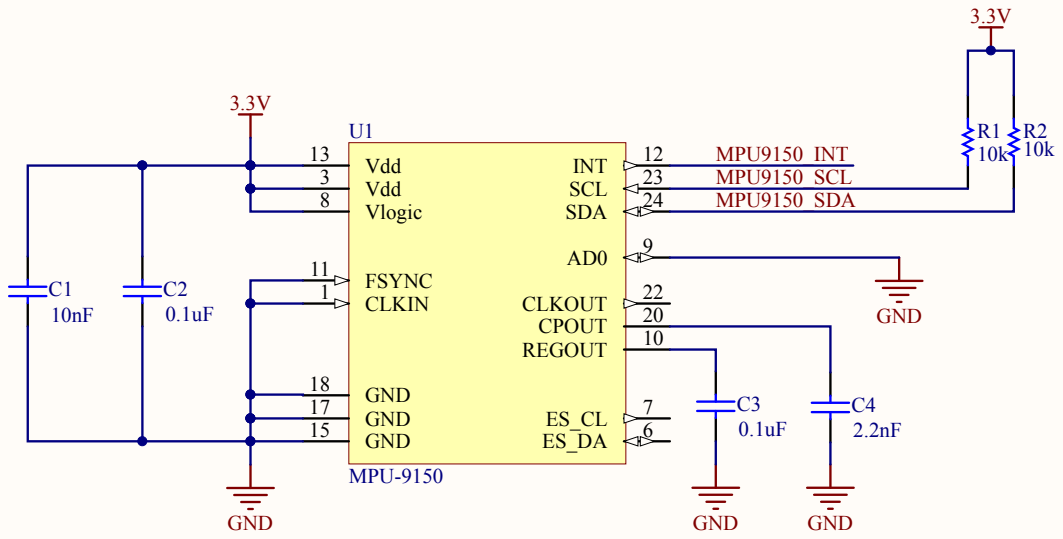
[picture p15: page 5]

8 | | MPU9150_SDA

GND 18

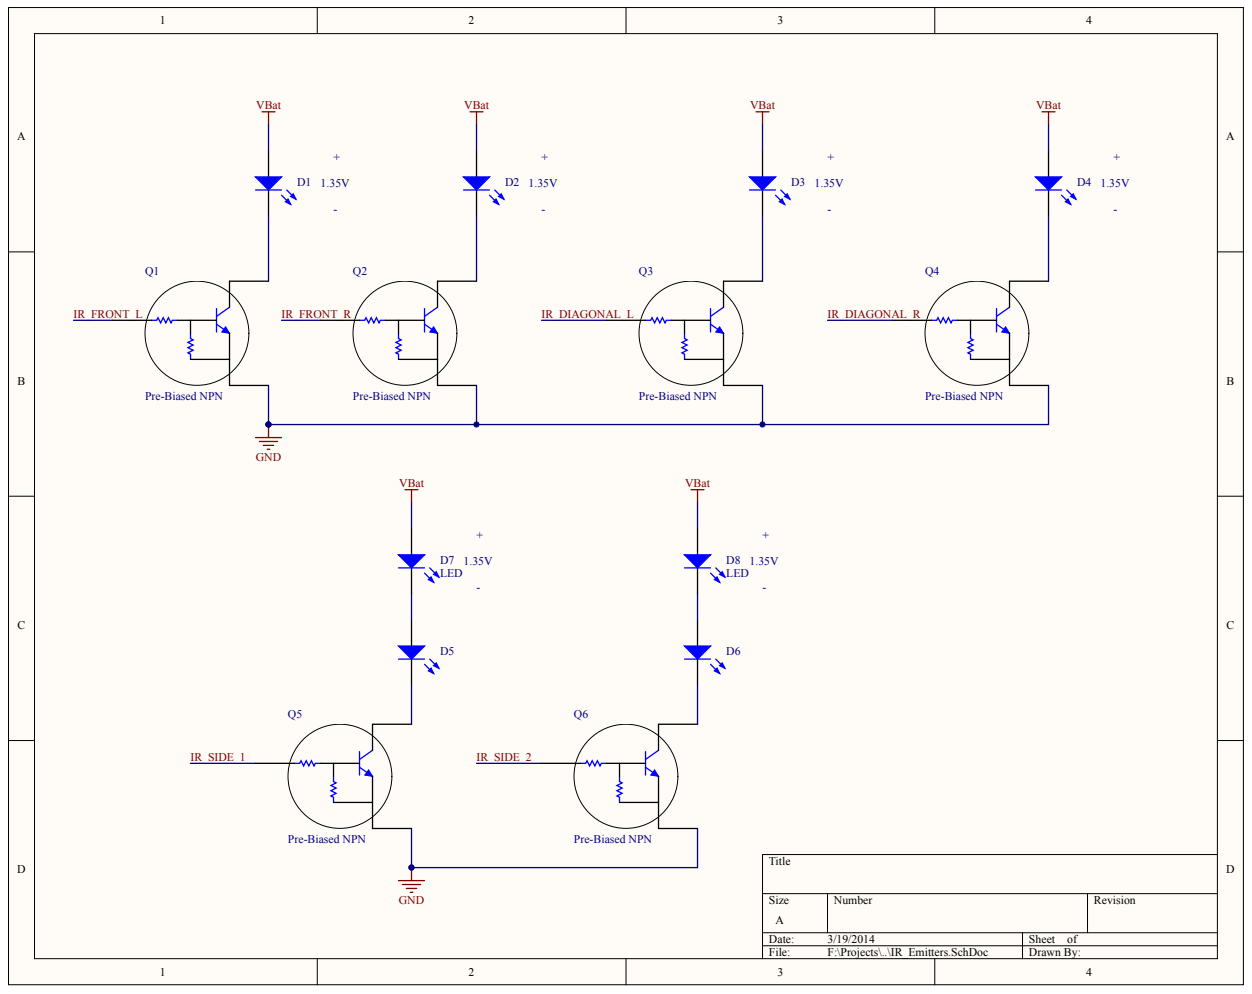
[picture p16: page 6]

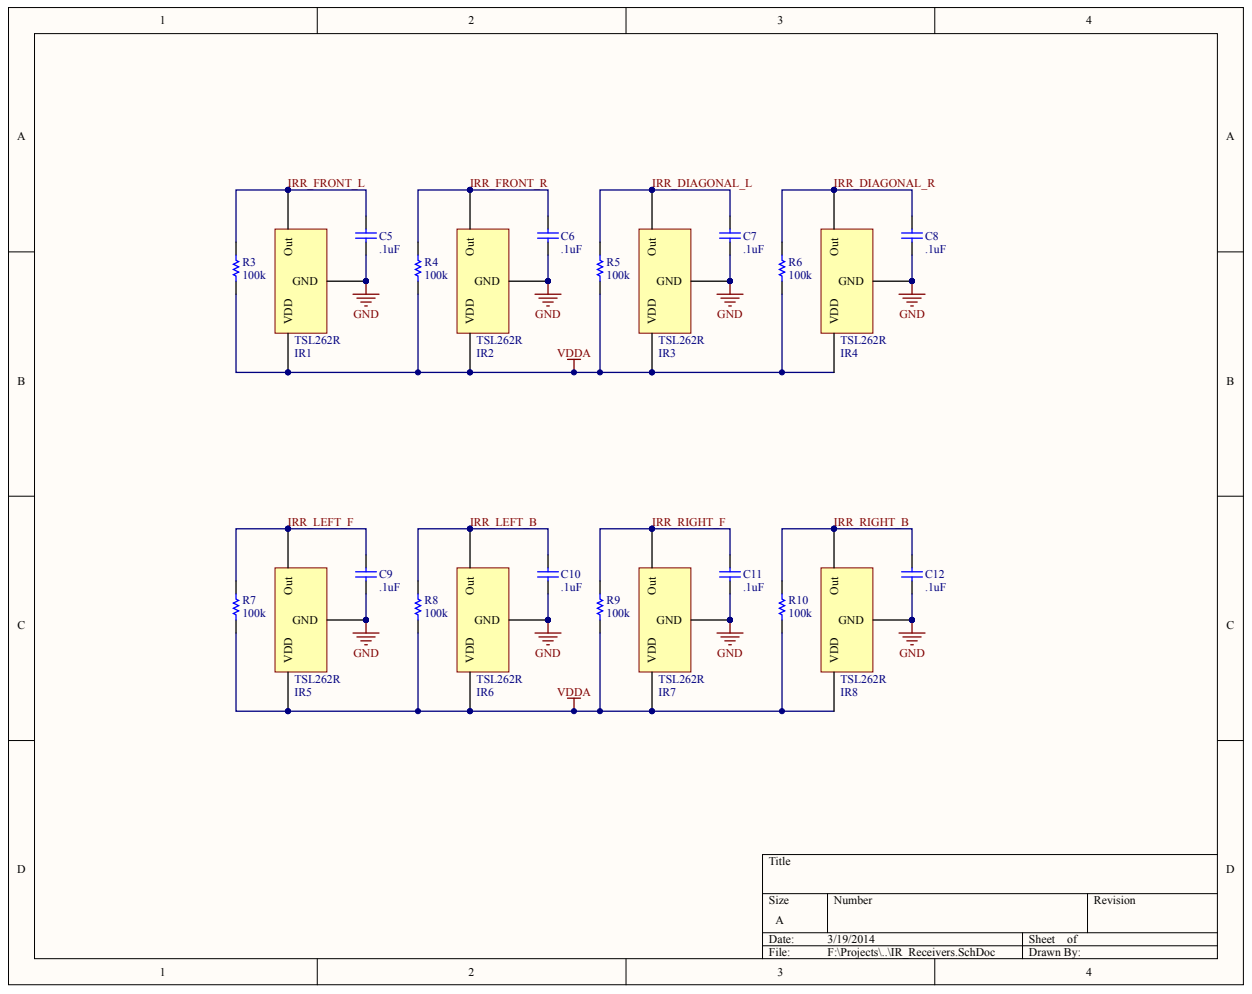
[picture p17: page 7]

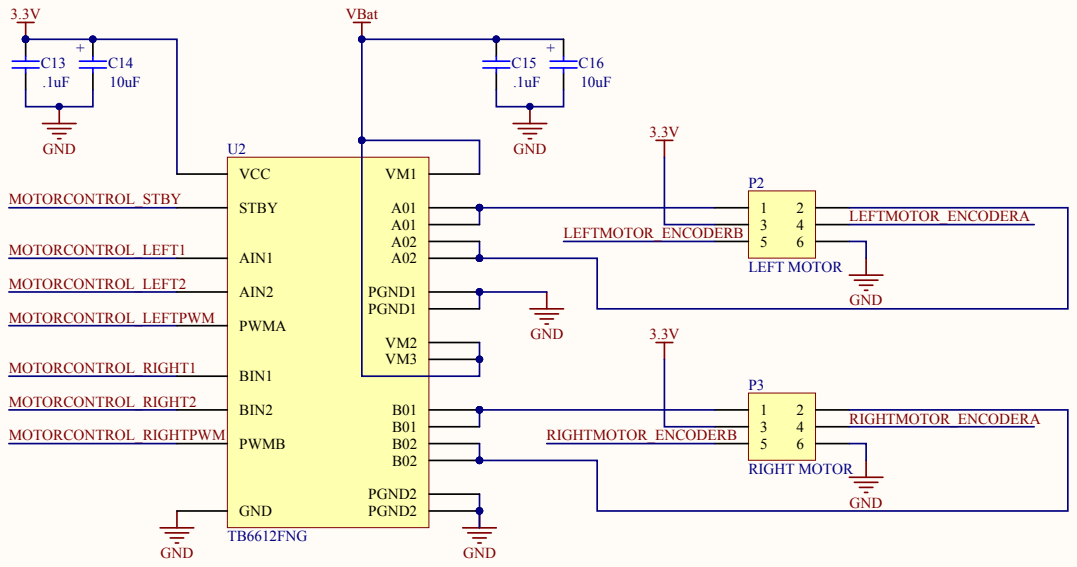
[picture p18: page 8]

GND

BIN2 PWMB GND | VM1

A01 A01 A02 A02 PGND1 PGND1 VM2 VM3

LEFTMOTOR_ENCODERB

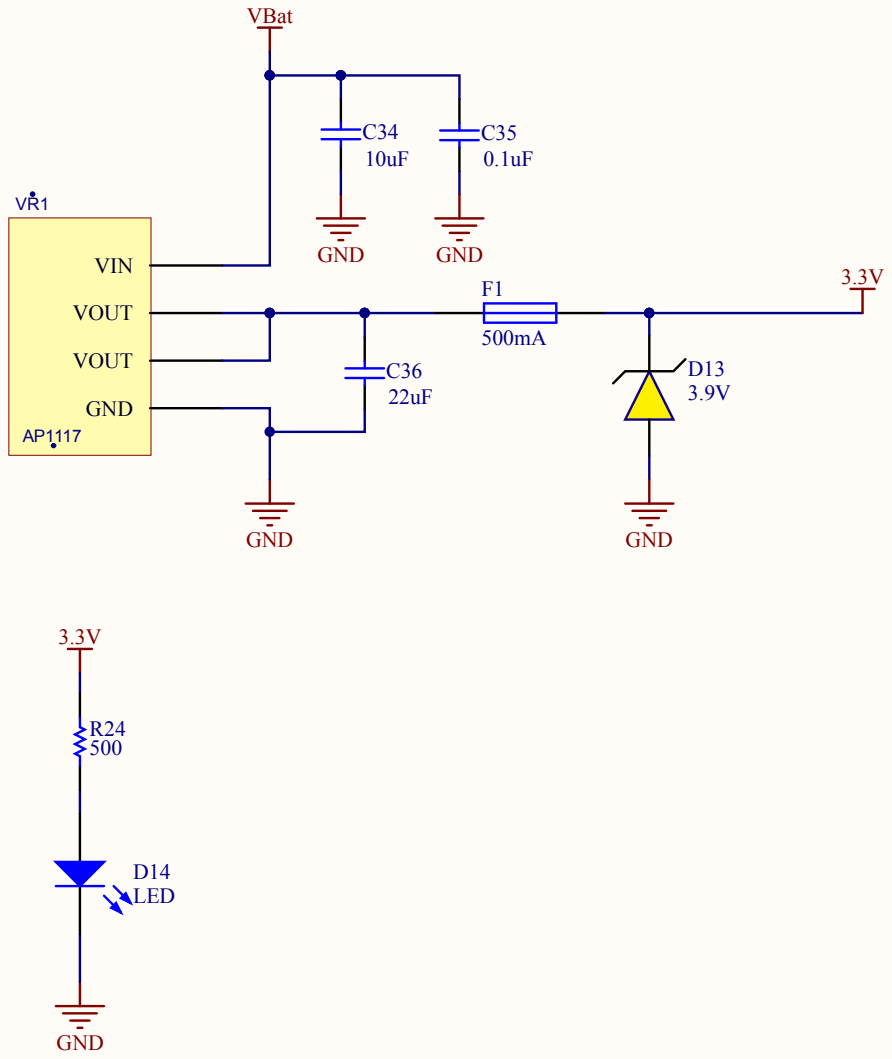
[picture p19: page 9]

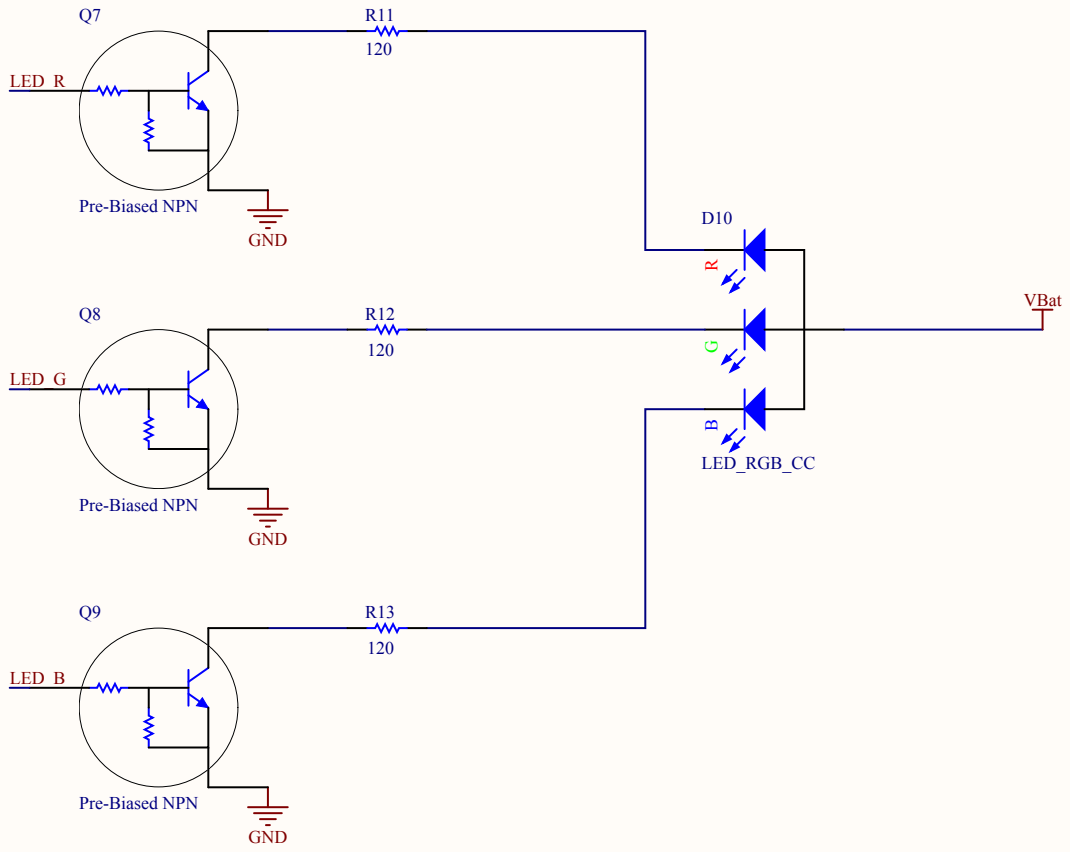
[picture p20: page 10]

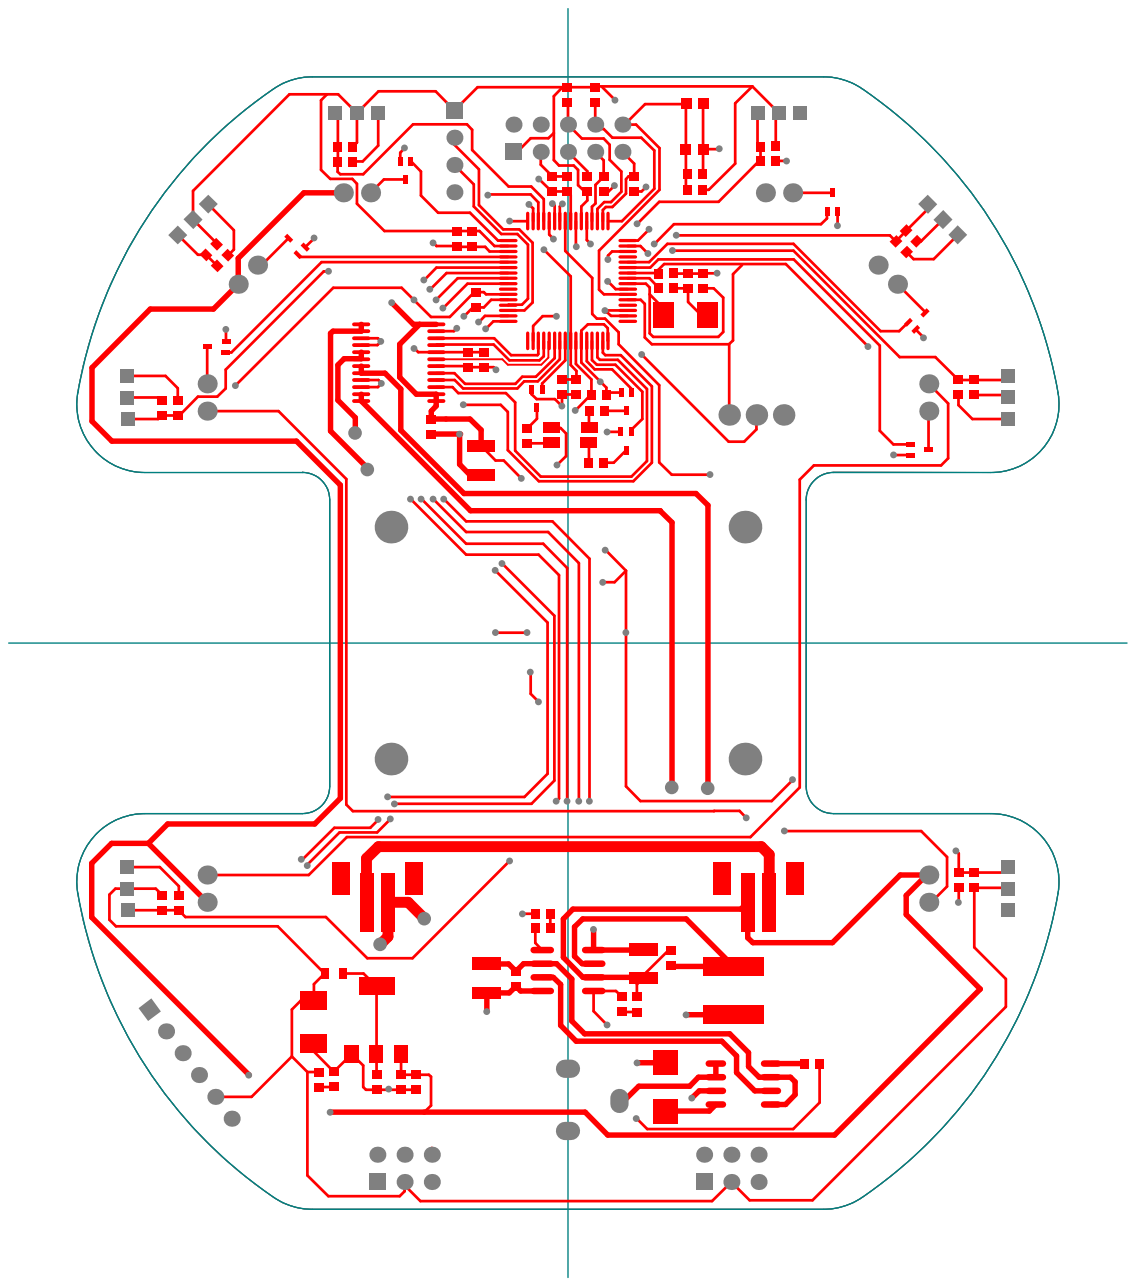
[picture p21: page 11]
