antmerlino/Micromouse/(list of files, drawings)

Other design files:
Hardware/battery_charger.SchDoc
Hardware/Bluetooth.SchDoc
Hardware/controller_peripherals.SchDoc
Hardware/controller_power.SchDoc
Hardware/Gyroscope-Acceleromter.SchDoc
Hardware/IR_Emitters.SchDoc
Hardware/IR_Receivers.SchDoc
Hardware/micromouse.PcbDoc
Hardware/micromouse.PrjPcb
Hardware/Motor Control.SchDoc
Hardware/Power_Regulation.SchDoc
Hardware/Status_LED.SchDoc
