antmerlino/Micromouse/Software/micromouse/services/control.c

/*
 * control.c
 *
 *  Created on: Mar 21, 2014
 *      Author: Anthony
 */
#include <stdint.h>
#include <stdbool.h>
#include <stdlib.h>
#include <stdio.h>
#include <string.h>
#include <math.h>

#include <ti/sysbios/family/arm/m3/Hwi.h>
#include <ti/sysbios/knl/Task.h>

#include <ti/sysbios/knl/Semaphore.h>
#include <ti/sysbios/BIOS.h>

#include <ti/drivers/GPIO.h>
#include <inc/hw_ints.h>
#include <inc/hw_gpio.h>

#include <xdc/runtime/System.h>

#include "system.h"

#include "drivers/motor.h"
#include "drivers/bluetooth.h"
#include "drivers/ir_sensor.h"
#include "drivers/led.h"

#include "services/pid.h"
#include "services/time_keeper.h"
#include "services/maze_solver.h"

#include "control.h"

#define LPF_SIZE 2

typedef struct straight_pid_params_t {
	float kp;
	float ki;
	float kd;
	uint32_t motor_speed;
}straight_pid_params_t;


straight_pid_params_t straight_control_params = {4.0, 1.0, 2.0, 200};

Semaphore_Handle drive_straight_sem_handle;
Semaphore_Params drive_straight_sem_params;

walls_t walls;

uint8_t explore = 1;
uint8_t restart_flag = 0;

uint8_t flood = 1;

side_ir_data_t side_data;

int * path_moves;

control_state_t micromouse_state = RESET;

pid_controller_t side_pid;

bool stream_buf_encoder = false;
char spf_buf_encoder[80];

bool stream_buf_motor = false;
char spf_buf_motor[80];

bool stream_buf_ctl = false;
char spf_buf_ctl[80];

bool delay_on = false;

bool stop_control_loop = true;

uint8_t startingpos = 0;
uint8_t maze_location_flag = 1;

uint8_t transition_region = 0;

uint8_t turn_around_dir = 0;
uint8_t turn_around_cal_flag = 0;

uint32_t right_previous_ticks = 0;
uint32_t left_previous_ticks = 0;

float motor_offset = 15;

#define CENTER_TRANSITION_REGION ((encoders.blocks * NUMTICKS_PER_BLOCK) - HALF_BLOCK)

void control_loop(){


	//uint32_t left_avg;
	//uint32_t right_avg;

	int32_t ir_diff;
	int32_t encoder_diff;

	float measurement;

	int16_t right_motor_out;
	int16_t left_motor_out;
	float error;
	float error_buf[LPF_SIZE];
	float *buf_ptr;
	float *buf_head;
	float *buf_tail;
	char buf[64];
	int str_len;

	buf_head = &error_buf[0];
	buf_ptr=buf_head;
	buf_tail = &error_buf[LPF_SIZE-1];


	while(1){

		Semaphore_pend(drive_straight_sem_handle, BIOS_WAIT_FOREVER);

		check_distance();

		side_poll(&side_data);
		check_walls(&walls, &side_data);

		switch(micromouse_state){

			case STRAIGHT:


				if( (!walls.flags.right && !walls.flags.left ) || (transition_region) ){

//					if( (encoders.left - left_previous_ticks) > (encoders.right - right_previous_ticks)){
//						motor_offset /= MOTOR_OFFSET_UPDATE;
//					}
//
//					if( (encoders.left - left_previous_ticks) < (encoders.right - right_previous_ticks)){
//						motor_offset *= MOTOR_OFFSET_UPDATE;
//					}

					error = 0;
				}
				else{

//					if( (encoders.left - left_previous_ticks) > (encoders.right - right_previous_ticks) && error > 0){
//						motor_offset /= MOTOR_OFFSET_UPDATE;
//					}
//
//					if( (encoders.left - left_previous_ticks) < (encoders.right - right_previous_ticks) && error < 0){
//						motor_offset *= MOTOR_OFFSET_UPDATE;
//					}

					error = pid_step(&side_pid, SETPOINT, walls.wall_diff, (float)get_curr_time_us())/100.0;
				}

//				left_previous_ticks = encoders.left;
//				right_previous_ticks = encoders.right;

				str_len = sprintf(buf, "E: %f\r\n",  error);
				bluetooth_transmit(buf, str_len);

				// Use the error term to correct the motors
				right_motor_out = straight_control_params.motor_speed - MOTOR_SPEED_OFFSET + error/2.0;
				left_motor_out = straight_control_params.motor_speed + MOTOR_SPEED_OFFSET - error/2.0;

				if(right_motor_out < 0){
					update_motor(RIGHT_MOTOR, CW, -1*right_motor_out);
				}
				else{
					update_motor(RIGHT_MOTOR, CCW, right_motor_out);
				}

				if(left_motor_out < 0){
					update_motor(LEFT_MOTOR, CCW, -1*left_motor_out);
				}
				else{
					update_motor(LEFT_MOTOR, CW, left_motor_out);
				}

				if(stream_buf_motor){
					int len = sprintf(spf_buf_motor, "L: %i, R: %i, D: %f\r\n", left_motor_out, right_motor_out, measurement);
					bluetooth_transmit(spf_buf_motor, len);
				}

				if(stream_buf_ctl){
					int len = sprintf(spf_buf_ctl, "IR: %i, E: %i, M: %f\r\n", ir_diff, encoder_diff, measurement);
					bluetooth_transmit(spf_buf_ctl, len);
				}

				break;

			case TURN_AROUND:

				if(turn_around_dir){
					update_motor(RIGHT_MOTOR, CW, TURN_SPEED - MOTOR_SPEED_OFFSET);
					update_motor(LEFT_MOTOR, CW, TURN_SPEED + MOTOR_SPEED_OFFSET);
				}
				else{
					update_motor(RIGHT_MOTOR, CCW, TURN_SPEED - MOTOR_SPEED_OFFSET);
					update_motor(LEFT_MOTOR, CCW, TURN_SPEED + MOTOR_SPEED_OFFSET);
				}

				pid_init(&side_pid, straight_control_params.kp, straight_control_params.ki, straight_control_params.kd, (float)get_curr_time_us());
				break;

			case TURN_RIGHT:

				update_motor(RIGHT_MOTOR, CW, TURN_SPEED - MOTOR_SPEED_OFFSET);
				update_motor(LEFT_MOTOR, CW, TURN_SPEED + MOTOR_SPEED_OFFSET);
				pid_init(&side_pid, straight_control_params.kp, straight_control_params.ki, straight_control_params.kd, (float)get_curr_time_us());
				break;

			case TURN_LEFT:

				update_motor(RIGHT_MOTOR, CCW, TURN_SPEED - MOTOR_SPEED_OFFSET);
				update_motor(LEFT_MOTOR, CCW, TURN_SPEED + MOTOR_SPEED_OFFSET);
				pid_init(&side_pid, straight_control_params.kp, straight_control_params.ki, straight_control_params.kd, (float)get_curr_time_us());
				break;

			case RESET:

				update_motor(LEFT_MOTOR, CW, 0);
				update_motor(RIGHT_MOTOR, CCW, 0);
				pid_init(&side_pid, straight_control_params.kp, straight_control_params.ki, straight_control_params.kd, (float)get_curr_time_us());

				break;

			case START:

				Task_sleep(2000);

				walls.wall_int = 0;
				walls.flags.right = 1;
				walls.flags.left = 1;

				if(explore){

					maze_clear();
					maze_init_ff();
					maze_set_start_rotation(180); // Assuming we are starting backwards
					cal_center(&side_data);
					maze_update_node(INITIAL_WALLS);

					if(micromouse_state != RESET){
						micromouse_state = (control_state_t) maze_next_direction_ff();
					}
				}
				else{

					if(startingpos){
						path_moves = maze_dijkstras_algorithm(15, 0, 8, 8);
					}
					else{
						path_moves = maze_dijkstras_algorithm(0, 0, 8, 8);
					}

					if(micromouse_state != RESET){
						micromouse_state = (control_state_t)*path_moves;
					}
					path_moves++;

				}

				encoders.blocks = 1;
				encoders.left = 0;
				encoders.right = 0;
				right_previous_ticks = 0;
				left_previous_ticks = 0;

				break;

			default:
				break;
		}
	}
}

void check_distance(){

	uint32_t avg_ticks;
	avg_ticks = (encoders.right + encoders.left)/2;

	switch(micromouse_state){

		case STRAIGHT:

			if( (avg_ticks >  CENTER_TRANSITION_REGION - TRANSITION_THRESHOLD) && (avg_ticks <  CENTER_TRANSITION_REGION + TRANSITION_THRESHOLD ) ){
				transition_region = 1;
			}
			else{
				transition_region = 0;
			}

			if( (avg_ticks >= encoders.blocks * NUMTICKS_PER_BLOCK) || (walls.flags.front && (avg_ticks >= encoders.blocks * NUMTICKS_PER_BLOCK - 80)) ){

				if(walls.flags.front){
					calibrate_front();
				}

				side_poll(&side_data);
				check_walls(&walls, &side_data);

				if(explore){

					if(micromouse_state != RESET){
						if(!walls.flags.left && maze_location_flag){
							micromouse_state = TURN_AROUND;
							startingpos = 1;
						}
						else if(!walls.flags.right && maze_location_flag){
							maze_location_flag = 0;
							maze_update_node( walls.wall_int );
							micromouse_state = (control_state_t) maze_next_direction_ff();
						}
						else if(maze_location_flag){
							if(walls.flags.front){
								maze_location_flag = 0;
								maze_clear();
								maze_init_ff();
								maze_set_start_point(15, 0);
								maze_set_start_rotation(180);
								maze_update_node(INITIAL_WALLS);
								micromouse_state = (control_state_t) maze_next_direction_ff();
							}
							else{
								micromouse_state = STRAIGHT;
							}
						}
						else{
							maze_update_node( walls.wall_int );
							if(flood){
								micromouse_state = (control_state_t) maze_next_direction_ff();
							}
							else{
								micromouse_state = (control_state_t) maze_next_direction_dfs();
							}

						}
					}

					check_walls(&walls, &side_data);

				}
				else
				{
					if(micromouse_state != RESET){
						micromouse_state = (control_state_t)*path_moves;
						path_moves++;
					}
				}

				if(micromouse_state != STRAIGHT){
					update_motor(LEFT_MOTOR, BRAKE, 500);
					update_motor(RIGHT_MOTOR, BRAKE, 500);
					Task_sleep(250);
				}

				if(delay_on){
					update_motor(LEFT_MOTOR, CW, 0);
					update_motor(RIGHT_MOTOR, CCW, 0);

					Task_sleep(1000);
				}

				// If we are about to turn left AND we have a wall on our right, calibrate against the right wall
				if(micromouse_state == TURN_LEFT && walls.flags.right){
					calibrate_right();
					micromouse_state = TURN_RIGHT;
				}

				// If we are about to turn right AND we have a wall on our left, calibrate against the left wall
				if(micromouse_state == TURN_RIGHT && walls.flags.left){
					calibrate_left();
					micromouse_state = TURN_LEFT;
				}

				// If we are about to turn around AND we have a wall on our right, calibrate against the right wall
				if(micromouse_state == TURN_AROUND && walls.flags.right){
					calibrate_right();
					turn_around_dir = 1;
				}

				// If we are about to turn around AND we have a wall on our left, calibrate against the left wall
				if(micromouse_state == TURN_AROUND && walls.flags.left){
					calibrate_left();
					turn_around_dir = 0;
				}

				// If we are turning right, and there's no wall in front, we won't be able to calibrate the turn once completed,
				// To remedy this, we check if there is a right wall, if so, we should turn towards it first, then calibrate,
				// then turn around
				if( micromouse_state == TURN_RIGHT && walls.flags.left && !walls.flags.front){
					micromouse_state = TURN_LEFT;
				}

				// If we are turning left, and there's no wall in front, we won't be able to calibrate the turn once completed,
				// To remedy this, we check if there is a left wall, if so, we should turn towards it first, then calibrate,
				// then turn around
				if( micromouse_state == TURN_LEFT && walls.flags.right && !walls.flags.front){
					micromouse_state = TURN_RIGHT;
				}


				if(micromouse_state == STRAIGHT){
					encoders.blocks++;
				}
				else{
					encoders.blocks = 1;
					encoders.right = 0;
					encoders.left = 0;
					right_previous_ticks = 0;
					left_previous_ticks = 0;
				}

				if(micromouse_state == RESET){

					if(flood){
						flood = 0;
						restart_flag = 1;
						micromouse_state = (control_state_t) maze_next_direction_dfs();
					}
					else{
						explore = 0;
						micromouse_state = START;
					}

					if(walls.flags.front){
						calibrate_front();
					}
				}

			}

			break;

		case TURN_AROUND:

			if(avg_ticks >= NUMTICKS_HALF_TURN && turn_around_cal_flag){

				// Brake!
				update_motor(LEFT_MOTOR, BRAKE, 500);
				update_motor(RIGHT_MOTOR, BRAKE, 500);

				Task_sleep(250);

				if(walls.flags.right){
					calibrate_right();
				}
				if(walls.flags.left){
					calibrate_left();
				}

				uint8_t i;
				for(i = 0; i < 5; i++)
				{
				side_poll(&side_data);
				check_walls(&walls, &side_data);
				}

				if(walls.flags.front){
					calibrate_front();
				}

				turn_around_cal_flag = 0;

				encoders.left = 0;
				encoders.right = 0;

				if(turn_around_dir){
					micromouse_state = TURN_RIGHT;
				}
				else{
					micromouse_state = TURN_LEFT;
				}

			}

			if(avg_ticks >= NUMTICKS_FULL_TURN){

				// Brake!
				update_motor(LEFT_MOTOR, BRAKE, 500);
				update_motor(RIGHT_MOTOR, BRAKE, 500);

				Task_sleep(250);

				uint8_t i;
				for(i = 0; i < 5; i++)
				{
				side_poll(&side_data);
				check_walls(&walls, &side_data);
				}

				if(walls.flags.left && walls.flags.right){
					calibrate_left();
					calibrate_right();
				}

				if(walls.flags.left && !walls.flags.right){
					calibrate_left();
				}

				if(walls.flags.right && !walls.flags.left){
					calibrate_right();
				}

				if(micromouse_state != RESET){
					micromouse_state = STRAIGHT;
				}
				encoders.right = 0;
				encoders.left = 0;
				right_previous_ticks = 0;
				left_previous_ticks = 0;

				turn_around_cal_flag = 1;

			}
			break;

		case TURN_RIGHT:

			if(avg_ticks >= NUMTICKS_HALF_TURN){

				// Brake!
				update_motor(LEFT_MOTOR, BRAKE, 500);
				update_motor(RIGHT_MOTOR, BRAKE, 500);

				Task_sleep(250);

				uint8_t i;
				for(i = 0; i < 5; i++)
				{
					side_poll(&side_data);
					check_walls(&walls, &side_data);
				}

				if(walls.flags.left && walls.flags.right){
					calibrate_left();
					calibrate_right();
				}

				if(walls.flags.left && !walls.flags.right){
					calibrate_left();
				}

				if(walls.flags.right && !walls.flags.left){
					calibrate_right();
				}

				if(micromouse_state != RESET){
					micromouse_state = STRAIGHT;
				}

				if(walls.flags.front){
					calibrate_front();
					square_front();
					calibrate_front();
					micromouse_state = TURN_AROUND;
				}

				encoders.right = 0;
				encoders.left = 0;
				right_previous_ticks = 0;
				left_previous_ticks = 0;

			}
		break;

		case TURN_LEFT:

			if(avg_ticks >= NUMTICKS_HALF_TURN){

				// Brake!
				update_motor(LEFT_MOTOR, BRAKE, 500);
				update_motor(RIGHT_MOTOR, BRAKE, 500);

				Task_sleep(250);

				uint8_t i;
				for(i = 0; i < 5; i++)
				{
				side_poll(&side_data);
				check_walls(&walls, &side_data);
				}

				if(walls.flags.left && walls.flags.right){
					calibrate_left();
					calibrate_right();
				}

				if(walls.flags.left && !walls.flags.right){
					calibrate_left();
				}

				if(walls.flags.right && !walls.flags.left){
					calibrate_right();
				}


				if(micromouse_state != RESET){
					micromouse_state = STRAIGHT;
				}

				if(walls.flags.front){
					calibrate_front();
					square_front();
					calibrate_front();
					micromouse_state = TURN_AROUND;
				}

				encoders.right = 0;
				encoders.left = 0;
				right_previous_ticks = 0;
				left_previous_ticks = 0;
			}
		break;

		default:
			break;
	}

	if(stream_buf_encoder){
		int len = sprintf(spf_buf_encoder, "L: %i, R: %i\r\n", encoders.left , encoders.right );
		bluetooth_transmit(spf_buf_encoder, len);
	}
}


void control_open() {
	GPIO_enableInt(INPUT_CTRL_SWITCH, GPIO_INT_BOTH_EDGES); // Enable interrupts
}

void control_init(){

	GPIOPinTypeGPIOInput(GPIO_PORTA_BASE, GPIO_PIN_1);
	GPIOPadConfigSet(GPIO_PORTA_BASE, GPIO_PIN_1, GPIO_STRENGTH_12MA, GPIO_PIN_TYPE_STD);

	time_keeper_init();
	pid_init(&side_pid, straight_control_params.kp, straight_control_params.ki, straight_control_params.kd, (float)get_curr_time_us());

	Semaphore_Params_init(&drive_straight_sem_params);
	drive_straight_sem_params.mode = Semaphore_Mode_BINARY;
	drive_straight_sem_handle = Semaphore_create(0, &drive_straight_sem_params, NULL);

	micromouse_state = RESET;

	maze_init_ff();

}

void set_pid_kp(char* val) {
	char buf[64];
	uint32_t val_int = atoi(val);
	straight_control_params.kp = val_int/100.0;
	pid_init(&side_pid, straight_control_params.kp, straight_control_params.ki, straight_control_params.kd, (float)get_curr_time_us());
	uint8_t len = sprintf(buf, "Straight PID KP set to: %3f\r\n", straight_control_params.kp);
	bluetooth_transmit(buf, len);
}

void set_pid_ki(char* val) {
	char buf[64];
	uint32_t val_int = atoi(val);
	straight_control_params.ki = val_int/100.0;
	pid_init(&side_pid, straight_control_params.kp, straight_control_params.ki, straight_control_params.kd, (float)get_curr_time_us());

	uint8_t len = sprintf(buf, "Straight PID KI set to: %3f\r\n", straight_control_params.ki);
	bluetooth_transmit(buf, len);
}

void set_pid_kd(char* val) {
	char buf[64];
	uint32_t val_int = atoi(val);
	straight_control_params.kd = val_int/100.0;
	pid_init(&side_pid, straight_control_params.kp, straight_control_params.ki, straight_control_params.kd, (float)get_curr_time_us());

	uint8_t len = sprintf(buf, "Straight PID KD set to: %3f\r\n", straight_control_params.kd);
	bluetooth_transmit(buf, len);
}

void set_motor_speed(char* val) {
	char buf[64];
	straight_control_params.motor_speed = atoi(val);
	update_motor(RIGHT_MOTOR, CCW, straight_control_params.motor_speed);
	update_motor(LEFT_MOTOR, CW, straight_control_params.motor_speed);
	uint8_t len = sprintf(buf, "Motors set to: %i\r\n", straight_control_params.motor_speed);
	bluetooth_transmit(buf, len);
}

void control_loop_resume(void){
	// Resume the task
	Semaphore_post(drive_straight_sem_handle);
}

void ctrlSwitchFxn(void) {

	if (micromouse_state == RESET){
		micromouse_state = START;
	}
	else{
		micromouse_state = RESET;
		if(restart_flag){
			explore = 0;
		}
	}

	GPIOIntClear(GPIO_PORTA_BASE, GPIO_PIN_1);
}

void stream_encoder(char* val) {
	if(strcmp(val, "on") == 0) {
		stream_buf_encoder = true;
	} else {
		if(strcmp(val, "off") == 0) {
			stream_buf_encoder = false;
		} else {
			bluetooth_transmit("Invalid Encoder Stream Value! 'on' or 'off'\r\n", 36);
		}
	}
}

void stream_motor(char* val) {
	if(strcmp(val, "on") == 0) {
		stream_buf_motor = true;
	} else {
		if(strcmp(val, "off") == 0) {
			stream_buf_motor = false;
		} else {
			bluetooth_transmit("Invalid Motor Stream Value! 'on' or 'off'\r\n", 36);
		}
	}
}

void stream_control(char* val) {
	if(strcmp(val, "on") == 0) {
		stream_buf_ctl = true;
	} else {
		if(strcmp(val, "off") == 0) {
			stream_buf_ctl = false;
		} else {
			bluetooth_transmit("Invalid Control Stream Value! 'on' or 'off'\r\n", 36);
		}
	}
}

void move_delay_tog(char* val){
	delay_on ^= 1;
}
