antmerlino/Micromouse/Software/micromouse/drivers/ir_sensor.h

#ifndef IR_ADC_SENSOR_H
#define IR_ADC_SENSOR_H

// Wall detection thresholds
#define FRONT_THRESHOLD 275
#define RIGHT_THRESHOLD 415
#define LEFT_THRESHOLD 415
#define DIAG_LEFT_THRESHOLD 300
#define DIAG_RIGHT_THRESHOLD 300

#define AVG_FRONT_THRESHOLD 20

#define FRONT_DIFF_THRESHOLD 20
#define LEFT_DIFF_THRESHOLD 20
#define RIGHT_DIFF_THRESHOLD 20

#define MOTOR_OFFSET_FRONTCAL 80

#define LF_OFFSET -57
#define RF_OFFSET 180
#define LB_OFFSET -45
#define RB_OFFSET 20


typedef struct {
	int32_t side_center_left;
	int32_t side_center_right;
	int32_t front_center;
	int32_t front_left_offset;
	int32_t front_right_offset;
} ir_cal_t;

extern ir_cal_t ir_cal_vals;

typedef union {

	uint32_t adc_data[6];

	struct{
		uint32_t left_front;
		uint32_t right_back;
		uint32_t right_front;
		uint32_t left_back;
		uint32_t junk1;
		uint32_t junk2;
	};

} side_ir_data_t;


typedef struct {

	uint32_t count;
	uint16_t front_sum;
	uint16_t left_sum;
	uint16_t right_sum;
	int32_t wall_diff;

	union {

		uint8_t wall_int;

		struct {
			uint8_t left : 1;
			uint8_t back : 1;
			uint8_t right : 1;
			uint8_t front : 1;
			uint8_t diag_left : 1;
			uint8_t diag_right : 1;
			uint8_t blank : 4;
		} flags;
	};
} walls_t;


void ir_sensor_init(void);
void cal_center(side_ir_data_t * side_ir_data);
void check_walls(walls_t * walls, side_ir_data_t * side_data);
void side_poll(side_ir_data_t * side_ir_data);
void front_poll(uint32_t * buf);
void update_ir_duty(char * value);
void calibrate_front(void);
void calibrate_left(void);
void calibrate_right(void);
void square_front(void);

// UART Callback
void stream_ir(char* val);

#endif
