antmerlino/Micromouse/(commit log)

2014-03-01 Creates Initial PCB project for hardware design. Adds board outline files from previous revision
    [board_rev1.0.dwg, board_rev1.0.dxf, micromouse.PrjPcb]
2014-03-01 Adds uM '13 design. Work will start from here.
    [Bluetooth.SchDoc, Controller.SchDoc, Controller[Conflict].SchDoc, Debug_Port.SchDoc, Gyroscope-Acceleromter.SchDoc, IR_Emitters.SchDoc, IR_Receivers.SchDoc, Motor Control.SchDoc]
2014-03-05 Updates most schematics with new library components. Adds battery charger schematic
    [BOM.ods, Bluetooth.SchDoc, Debug_Port.SchDoc, Gyroscope-Acceleromter.SchDoc, IR_Emitters.SchDoc, IR_Receivers.SchDoc, Motor Control.SchDoc, Power_Regulation.SchDoc]
2014-03-17 Adds pwm motor control module
2014-03-17 Adds PID Controller Service Implementation
2014-03-18 Makes the PID module a little less confusing
2014-03-19 Creates TI-RTOS project for micromouse software
    [700809344.sldasm, 700809600.sldasm, 700810240.sldasm, 700810368.sldasm, 700810496.sldasm, 700810624.sldasm, 700810752.sldasm, 700811008.sldasm]
2014-03-19 Addition of motor driver and structure changes to project
    [micromouse.cfg]
2014-03-19 Lets try this...
    [BIOS.obj, build.cfg, dmtimer_Timer_asm.obj, ducati_CTM_asm.obj, ducati_Core_asm.obj, m3_Clobber_asm.obj, m3_Hwi_asm.obj, m3_Hwi_asm_switch.obj]
2014-03-19 motor driver/CPU clk changes to account for 80MHz clk signal.
    [micromouse.cfg, micromouse_pem4f.cfg, motor.obj, pid.obj, time_keeper.obj]
2014-03-20 Add temporary (placeholder) ir_adc_sensor driver/
    [micromouse.cfg]
2014-03-22 Adds a buncha shit
    [IR_blokc.SLDPRT, micromouse.cfg]
2014-03-22 Implements UART messaging system.
    [micromouse.cfg]
2014-03-22 Finishes PID Drive Straight loop
    [board_rev1.0.dwg, board_rev1.0.dxf, board_rev1.1.dwg, board_rev1.1.dxf, ground_plane_outline.dxf, micromouse.cfg, rub_strip.dwg, rub_strip.dxf]
2014-03-22 Add Switch GPIO Callback
2014-03-26 Adds encoder module
    [micromouse.cfg]
2014-03-26 Submit alternative to Encoder AlGoreithm that uses GPIO.
2014-03-31 Updates with completed code. Not stable PID
    [BIOS.obj, ducati_Core_asm.obj, m3_Hwi_asm.obj, maze_solver.obj, micromouse.cfg, pid.obj, time_keeper.obj]
2014-04-01 Stable Version. Mouse drives relatively stable and straight. Calibration for front sensors required.
    [micromouse.cfg]
2014-04-01 Adds front calibration routine and offsets the motors for uneven behaviour
2014-04-02 Adds braking after turns, adds calibration routines for right and left walls after turns.
2014-04-02 Adds wall_diff thats fed to PID controller to the check_walls function. Attempts to consider the case where there may be a wall according to the front ir sensor but not according to the rear side ir.
2014-04-02 Cleans up a lot of code. Control system will only use front side IR data for PID loop. Adds step to calibrate_front() to square up with the wall before recalibrating distance.
    [maze_solver.obj, pid.obj, time_keeper.obj]
2014-04-03 Adds structure to hold encoder data. Now in the straights we keep track of total number of ticks too so that we can use it for dead reckoning system.
2014-04-03 Mostly stable... Static Calibration doe.
2014-04-04 IR calibration routine added. Most stable code yet.
2014-04-04 Seriously stable
    [micromouse.cfg]
2014-04-25 Begins to add documentation. Makes attempt to move some things from system.c to system.h but not sure if changes will work
    [micromouse.cfg]
2014-05-05 Fixes error with PID controller. Derivative term was not being multiplied by kd
    [pid.c]
